StokeDude18/m_monitron/Documentations/captures/40test.JPG

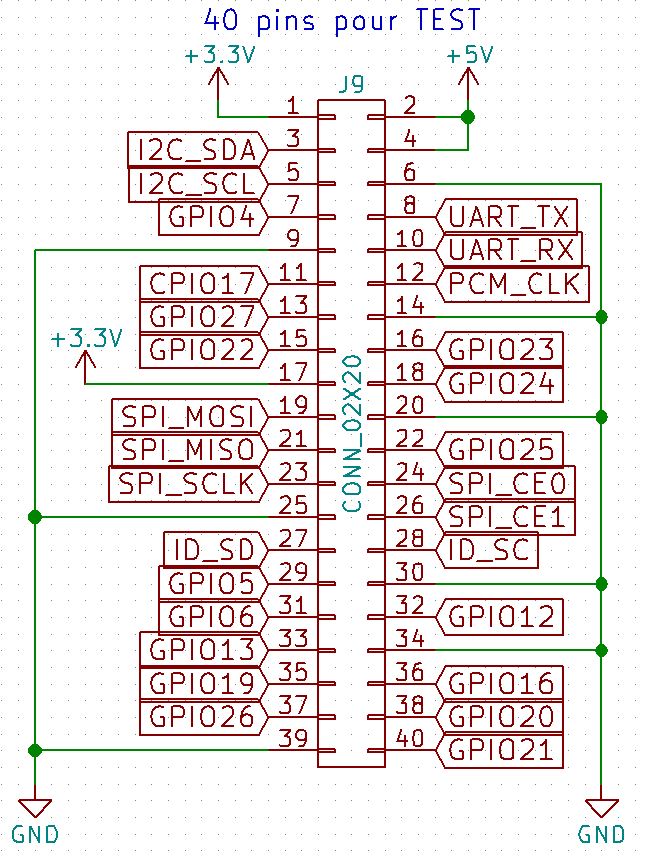
Documentations/captures/40test.JPG
