StokeDude18/m_monitron/Documentations/photos/4.jpg

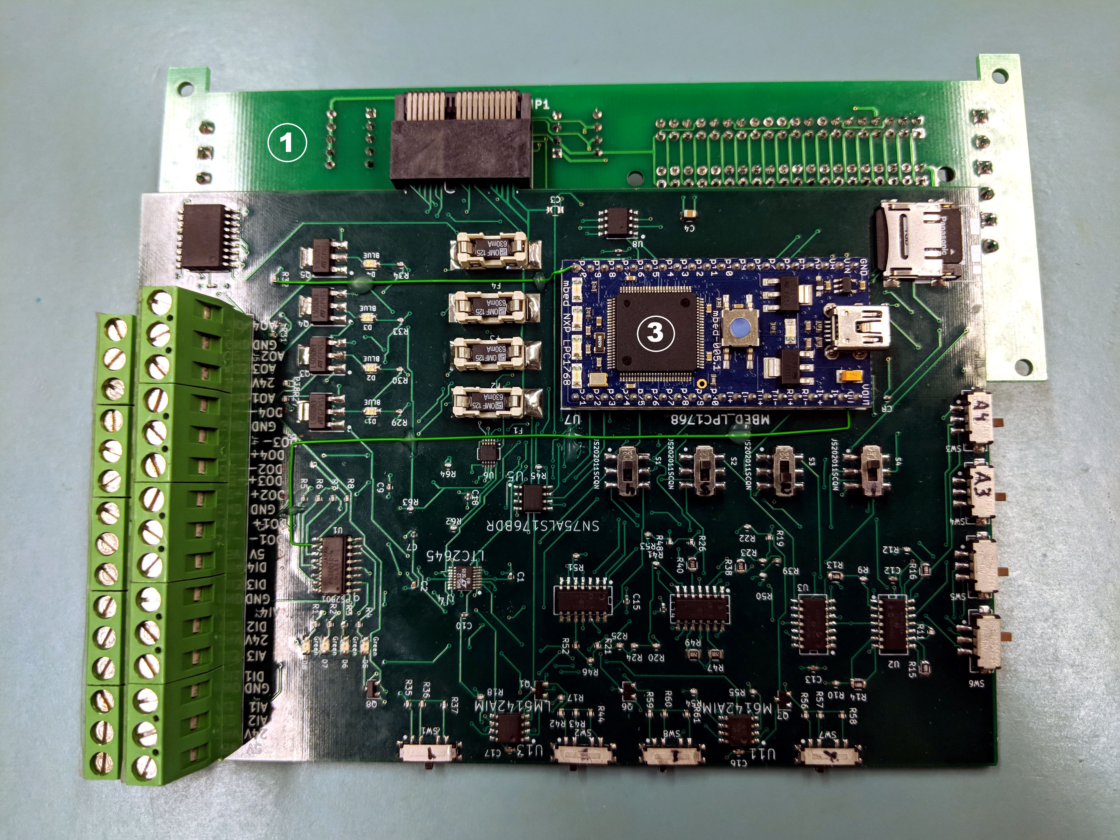
Documentations/photos/4.jpg
