StokeDude18/m_monitron/Documentations/ManuelTechnique_MiniMonitron.docx

Alfred Quintin-Morel

Maina Raiche

Technologie des systèmes ordinés

Groupe : 02317

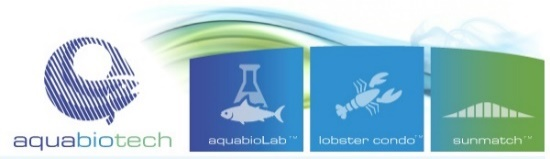
[picture p11: figure]

Mini-Monitron

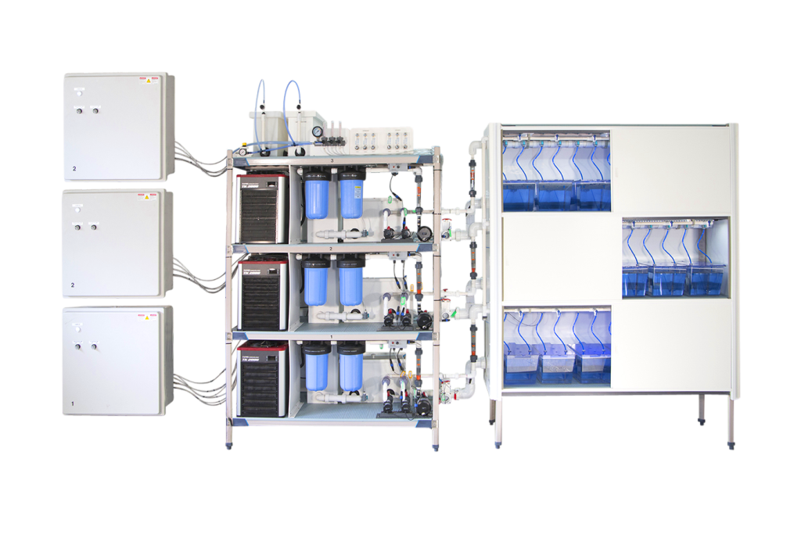
[picture p12: figure]

Manuel technique présenté à

Aquabiotech et Richard Cloutier

Département des technologies du génie électrique

Pour le cours

Projet de fin d’étude

cegep_coul_2225x798

18 mai 2018

# Description du projet

Fonctionnement (Schéma bloc)

Procédure d’installation (pour usager) après fabrication

Générer les fichiers Gerber (.gbr) avec Kicad

Contenu matériel du produit
