StokeDude18/m_monitron/Documentations/SchemaCodeMonitron.pdf

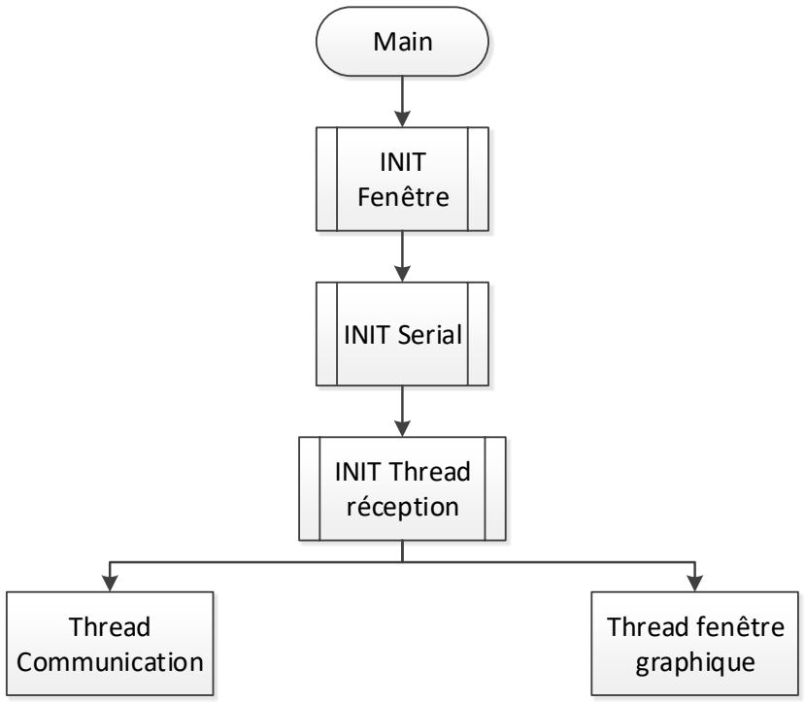
[picture p13: figure]
Main; INIT Fenêtre; INIT Serial; INIT Thread réception; Thread Communication; Thread fenêtre graphique

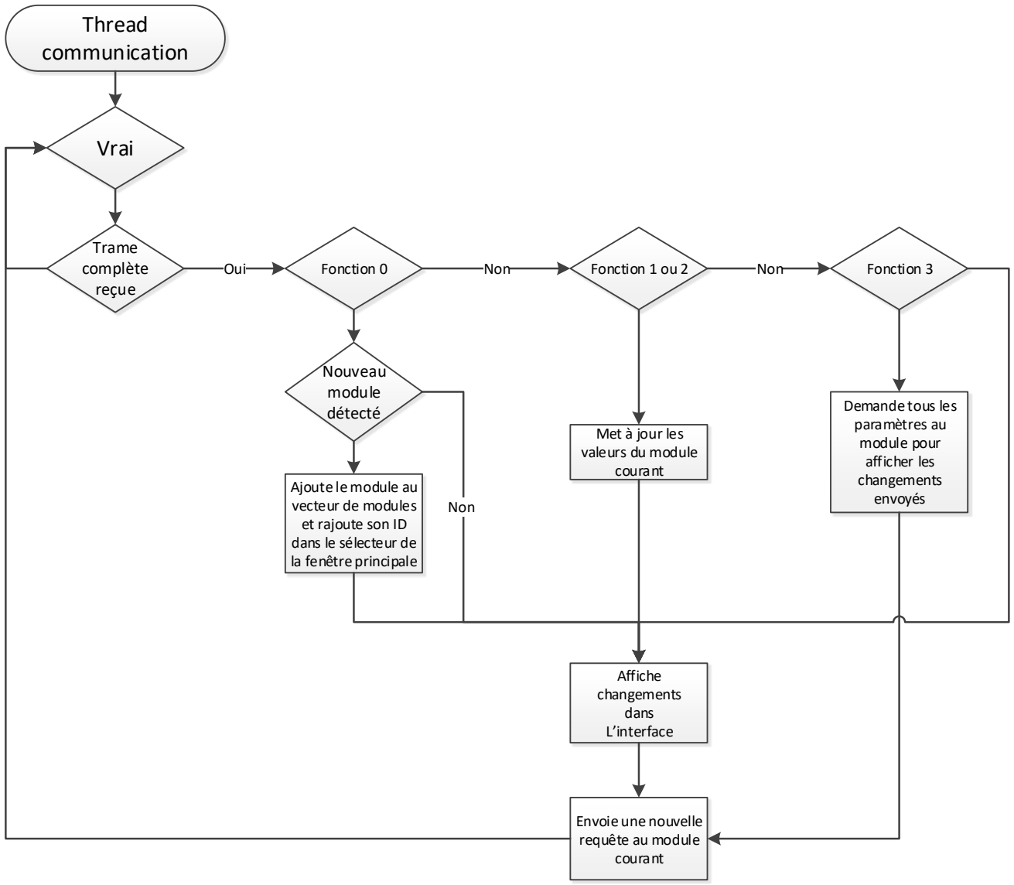
[picture p14: figure]
Thread communication; Vrai; Trame complète reçue; Oui; Fonction 0; Non; Fonction 1 ou 2; Fonction 3; Affiche changements dans L interface; Nouveau module détecté; Ajoute le module au vecteur de modules et rajoute son ID dans le sélecteur de la fenêtre principale; Met à jour les valeurs du module courant; Demande tous les paramètres au module pour afficher les changements envoyés; Envoie une nouvelle requête au module courant
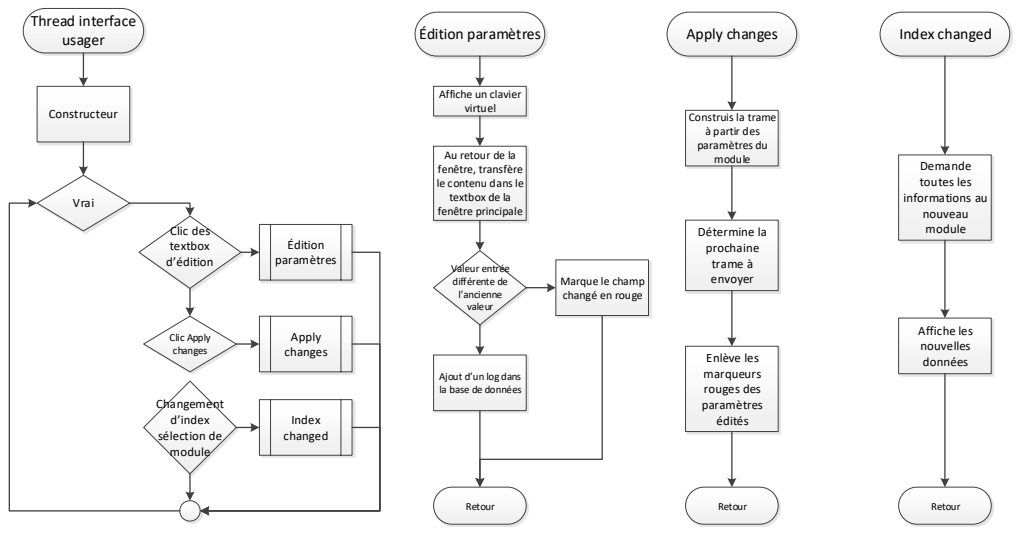
[picture p15: page 3]
Thread interface usager; Constructeur; Vrai; Clic des textbox d édition; Édition paramètres; Clic Apply changes; Apply changes; Changement d index sélection de module; Index changed; Valeur entrée différente de l ancienne valeur; Retour; Détermine la prochaine trame à envoyer; Enlève les marqueurs rouges des paramètres édités; Demande toutes les informations au nouveau module; Affiche les nouvelles données

Affiche un clavier
virtuel

Construis la trame
à partir des
paramètres du
module

Au retour de la
fenêtre, transfère
le contenu dans le
textbox de la
fenêtre principale

Marque le champ
changé en rouge

Ajout d un log dans
la base de données
