StokeDude18/m_monitron/Fiches_Technique/7-344,7-345.pdf

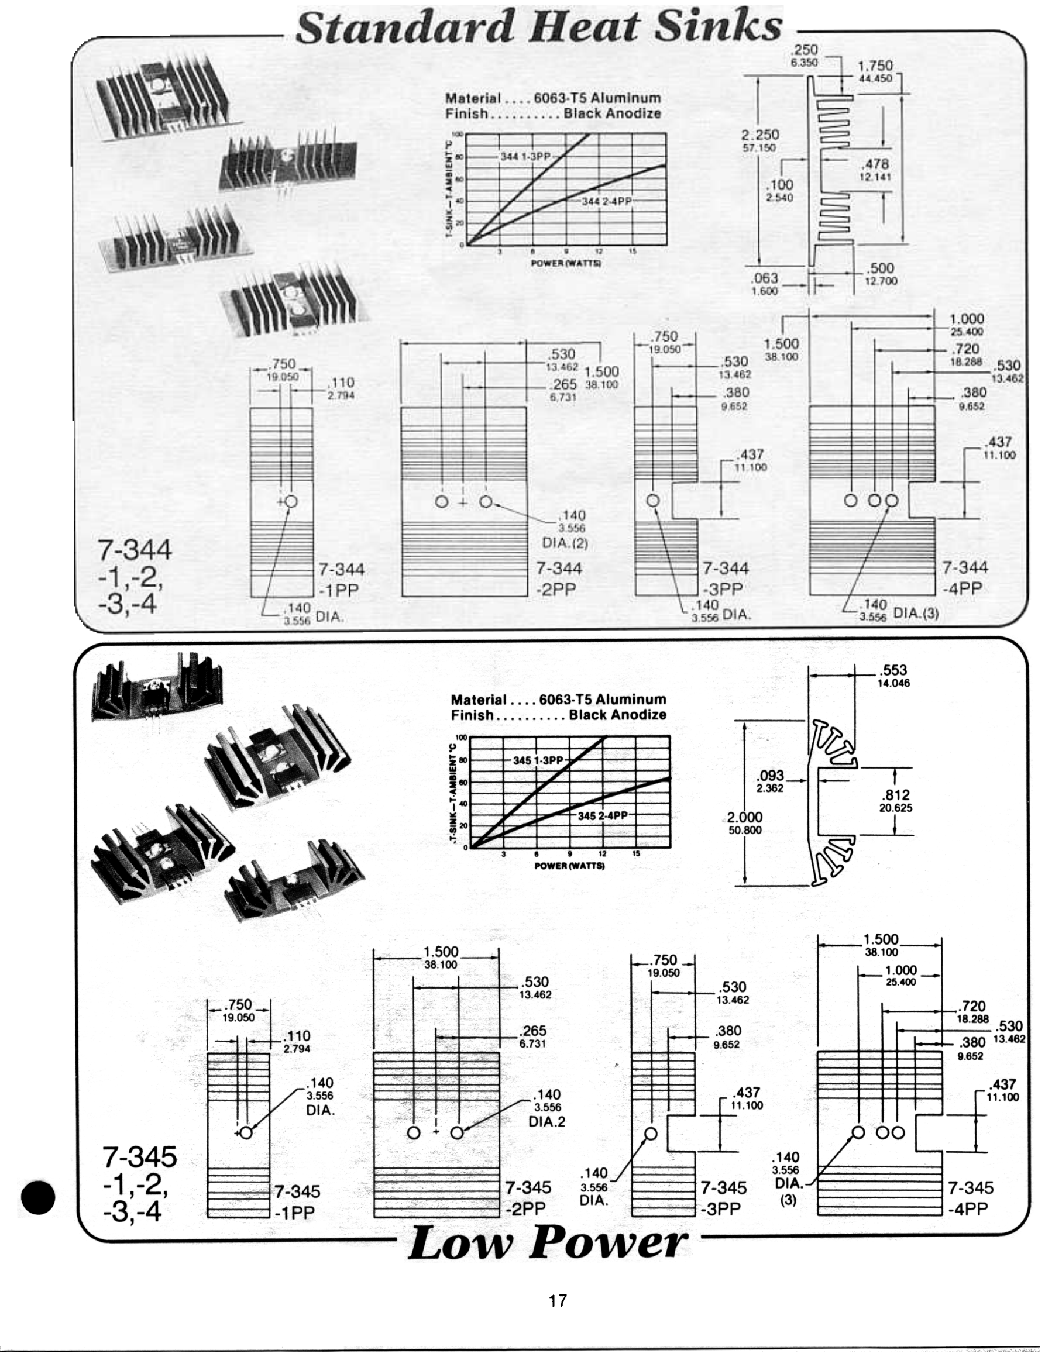
[picture p16: page 1]

17
