StokeDude18/m_monitron/Documentations/captures/24VDC.JPG

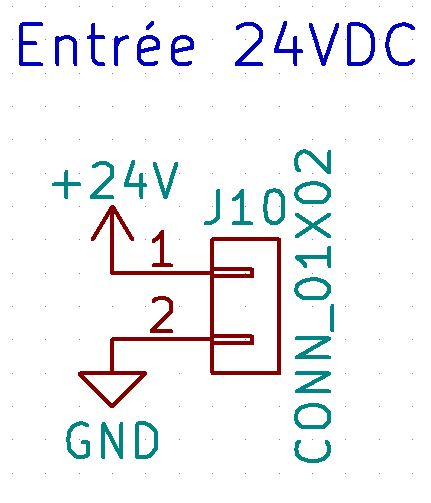
Documentations/captures/24VDC.JPG
