StokeDude18/m_monitron/Documentations/captures/40PI.JPG

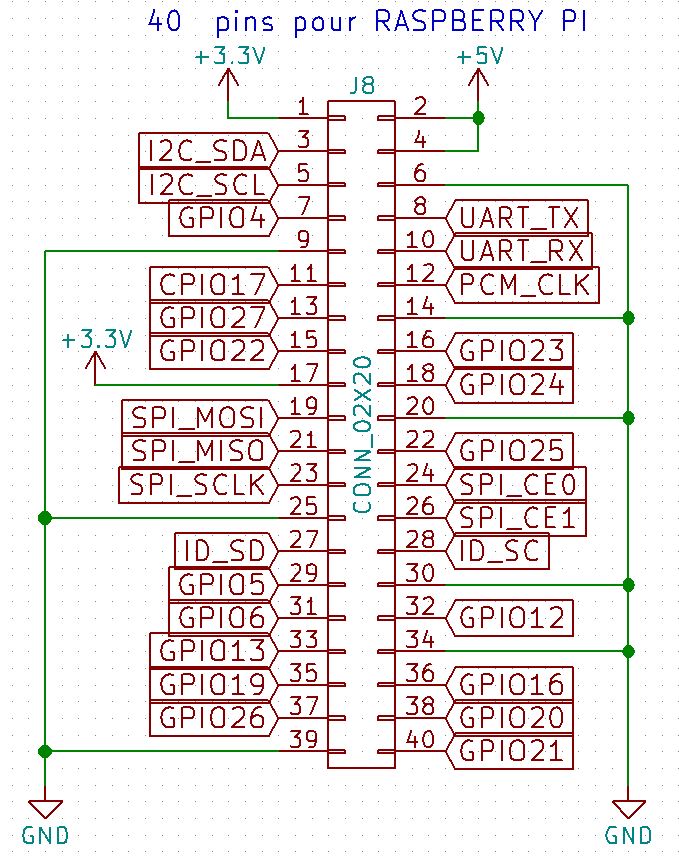
Documentations/captures/40PI.JPG
