StokeDude18/m_monitron/Documentations/captures/alim_mod.JPG

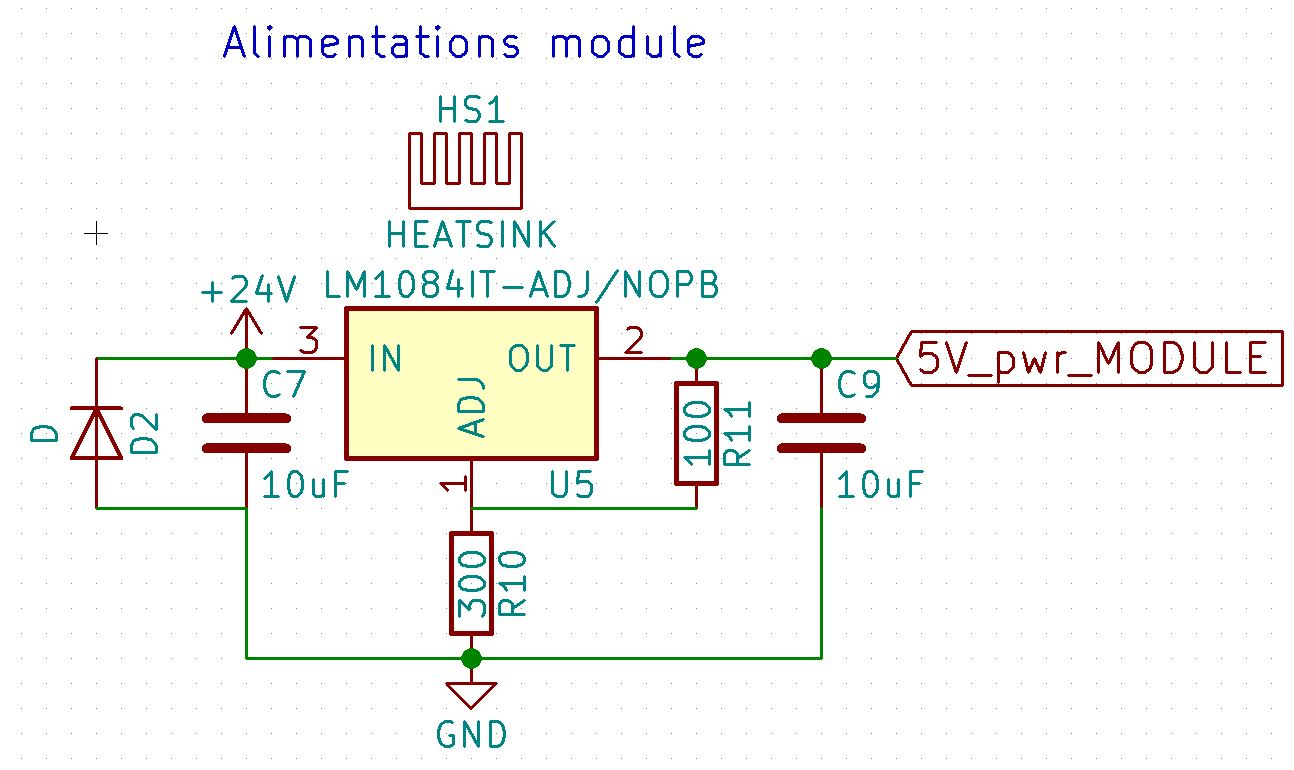
Documentations/captures/alim_mod.JPG
