StokeDude18/m_monitron/Documentations/captures/alim_PI.JPG

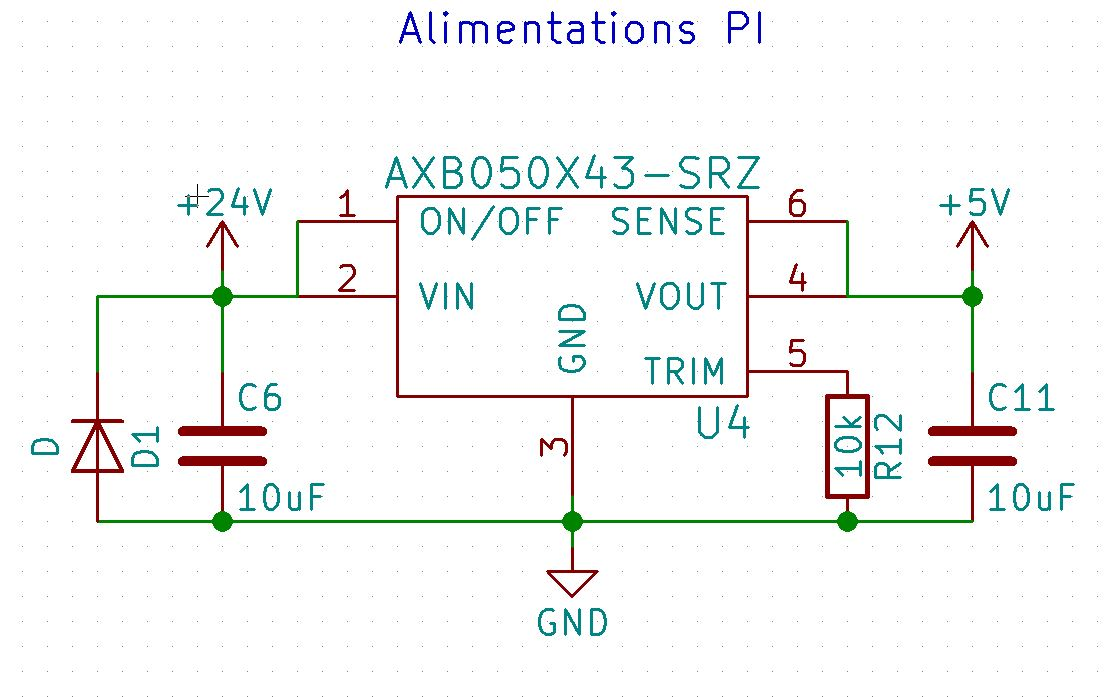
Documentations/captures/alim_PI.JPG
