StokeDude18/m_monitron/Documentations/captures/borniers.JPG

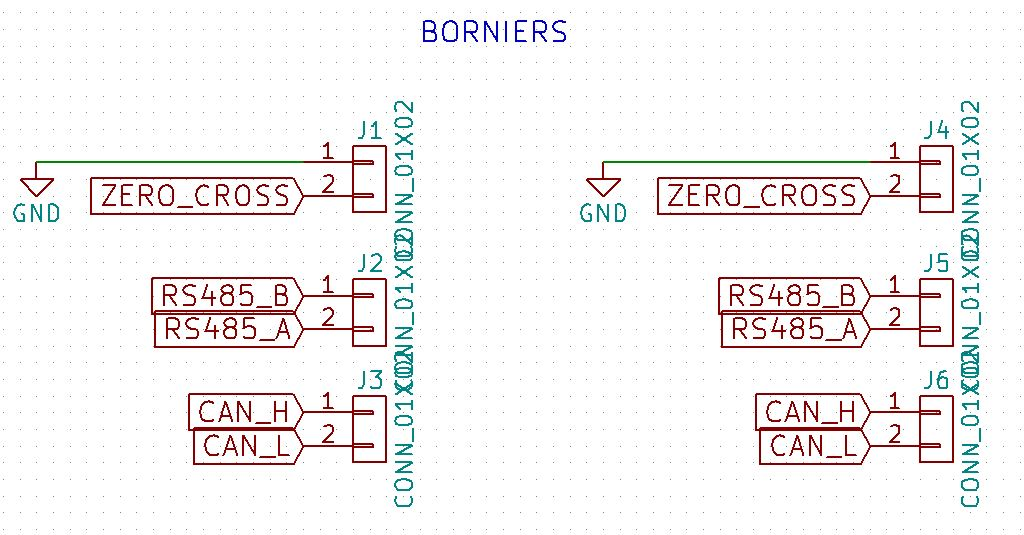
Documentations/captures/borniers.JPG
