StokeDude18/m_monitron/Documentations/captures/c_PI.JPG

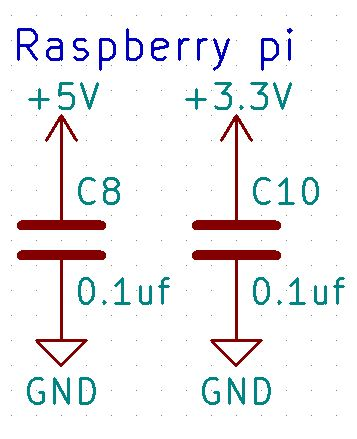
Documentations/captures/c_PI.JPG
