StokeDude18/m_monitron/Documentations/captures/CAN.JPG

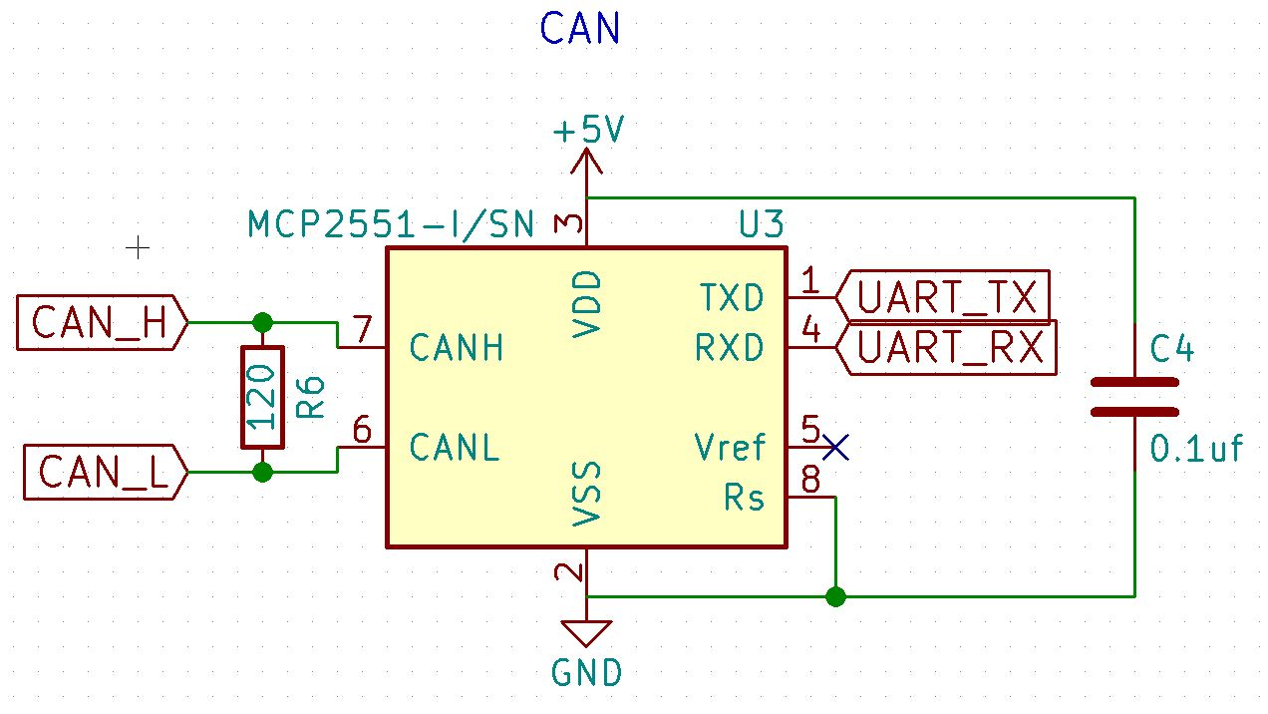
Documentations/captures/CAN.JPG
