StokeDude18/m_monitron/Documentations/captures/mysql1.JPG

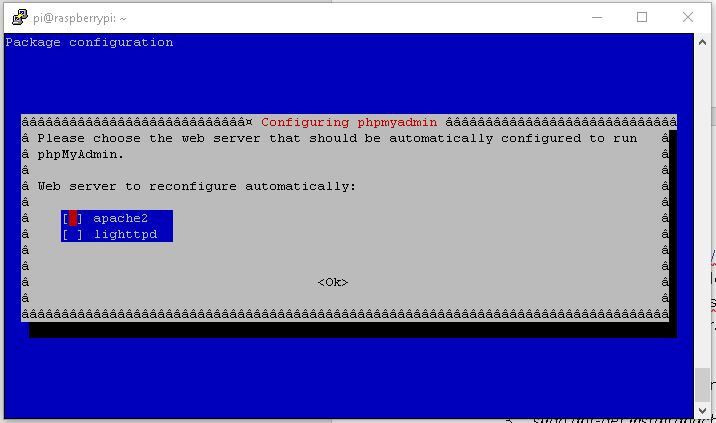
Documentations/captures/mysql1.JPG
