StokeDude18/m_monitron/Documentations/captures/mysql2.JPG

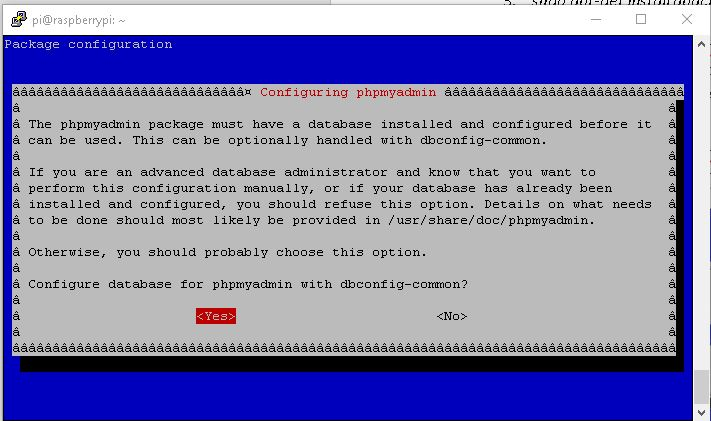
Documentations/captures/mysql2.JPG
