StokeDude18/m_monitron/Documentations/captures/mysql3.JPG

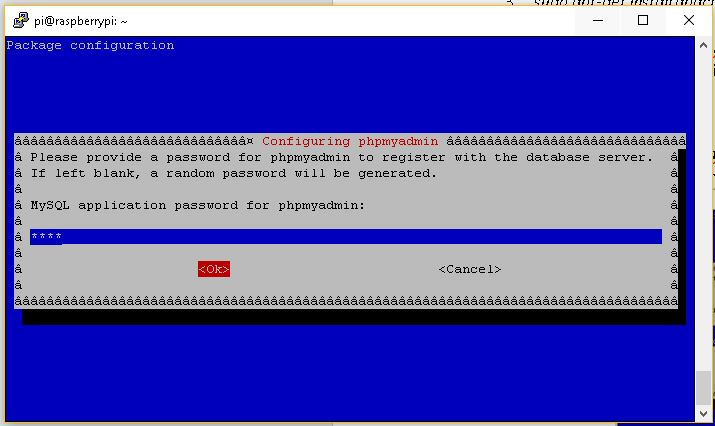
Documentations/captures/mysql3.JPG
