StokeDude18/m_monitron/Documentations/captures/mysql4.JPG

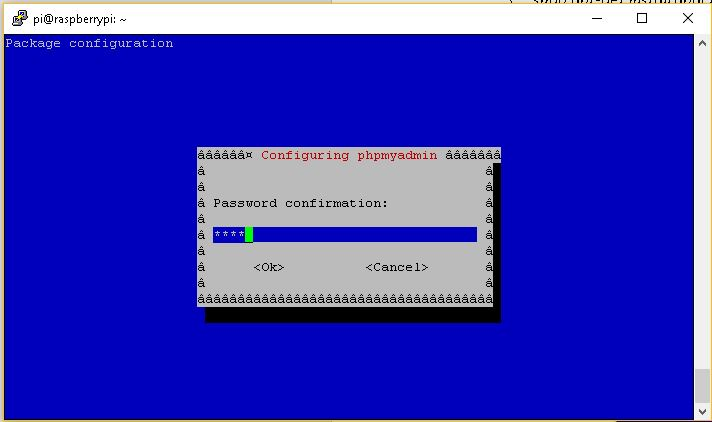
Documentations/captures/mysql4.JPG
