StokeDude18/m_monitron/Documentations/captures/mysql5.JPG

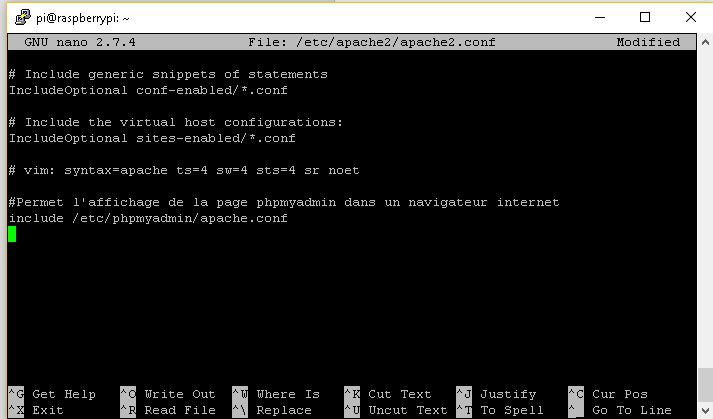
Documentations/captures/mysql5.JPG
