StokeDude18/m_monitron/Documentations/captures/ordino0.JPG

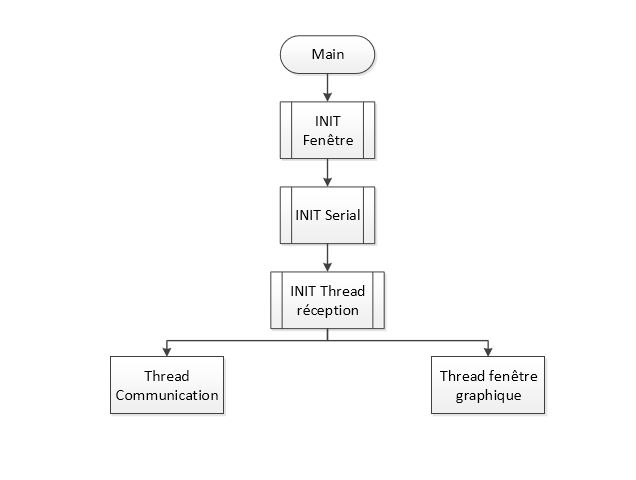
Documentations/captures/ordino0.JPG
