StokeDude18/m_monitron/Documentations/captures/ordino1.JPG

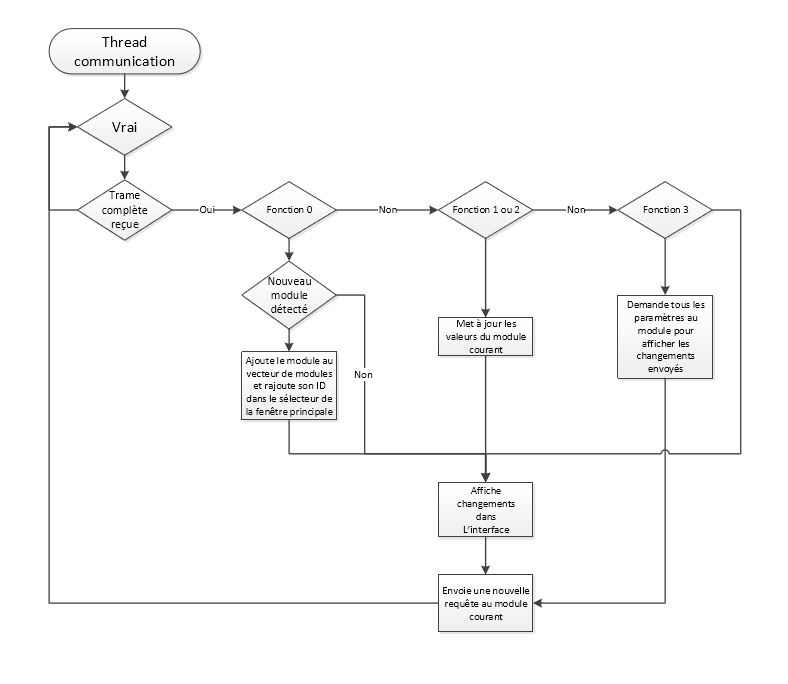
Documentations/captures/ordino1.JPG
