StokeDude18/m_monitron/Documentations/captures/pcie.JPG

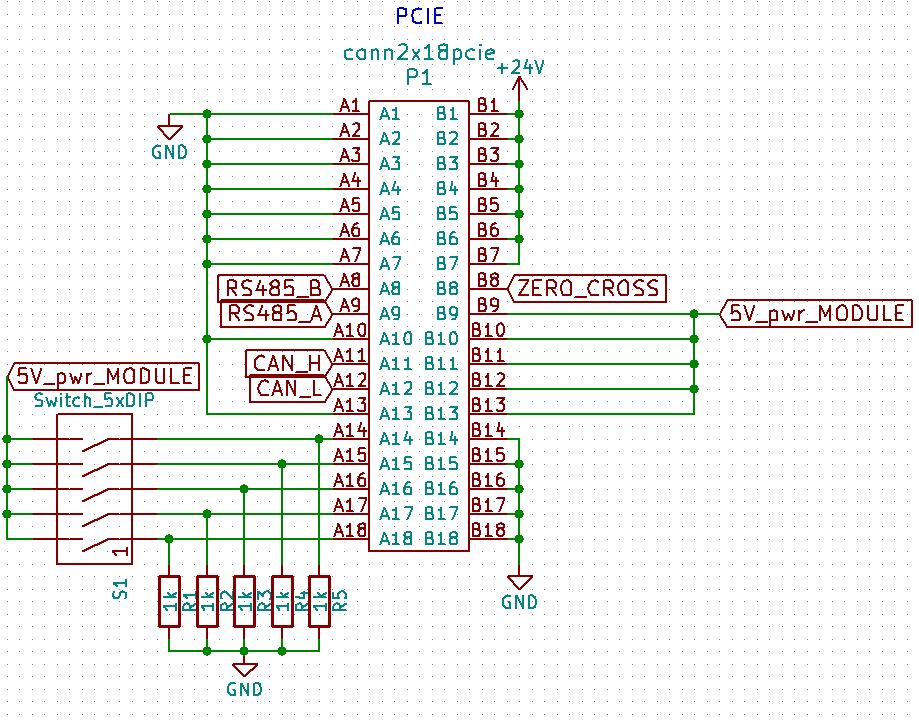
Documentations/captures/pcie.JPG
