StokeDude18/m_monitron/Documentations/captures/rtc.JPG

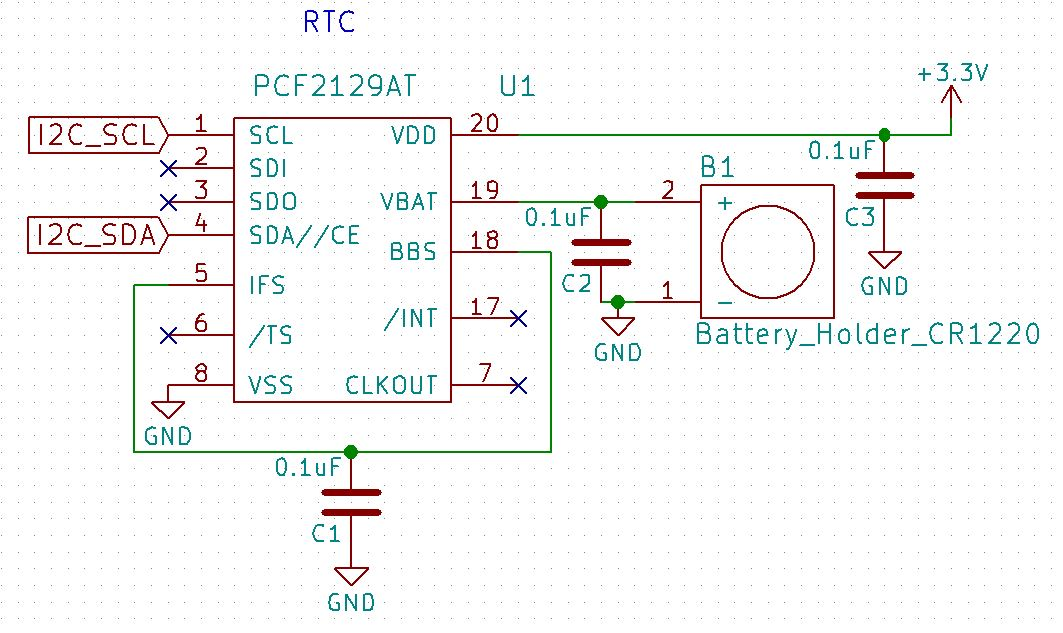
Documentations/captures/rtc.JPG
