StokeDude18/m_monitron/Documentations/captures/schemaelec.JPG

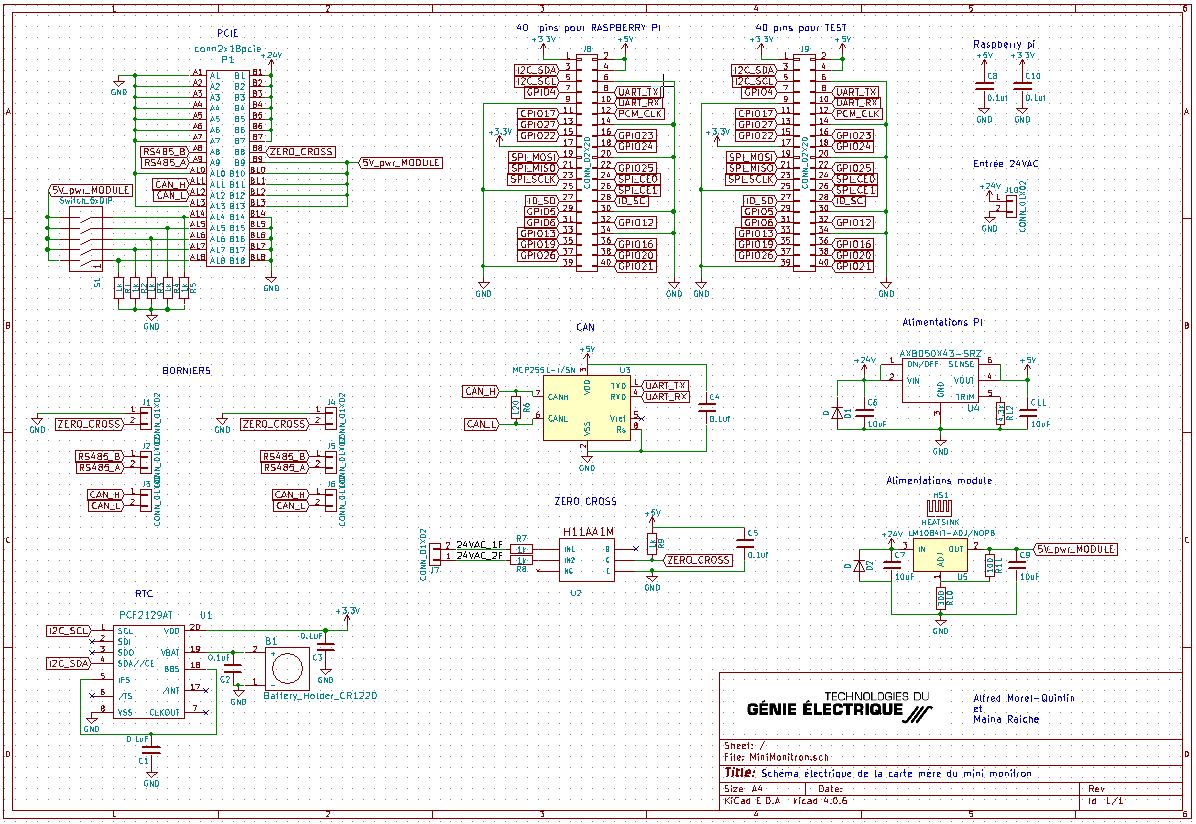
Documentations/captures/schemaelec.JPG
