StokeDude18/m_monitron/Documentations/captures/zerocross.JPG

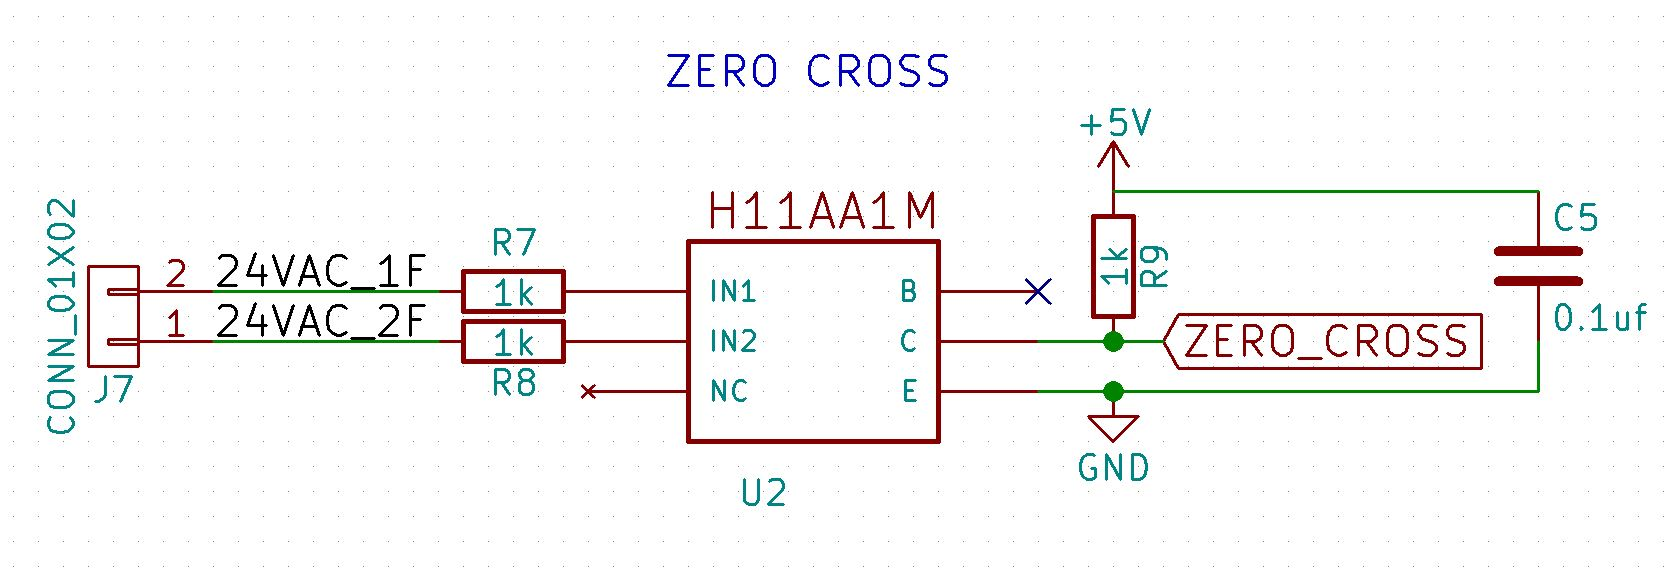
Documentations/captures/zerocross.JPG
