StokeDude18/m_monitron/Documentations/photos/0.jpg

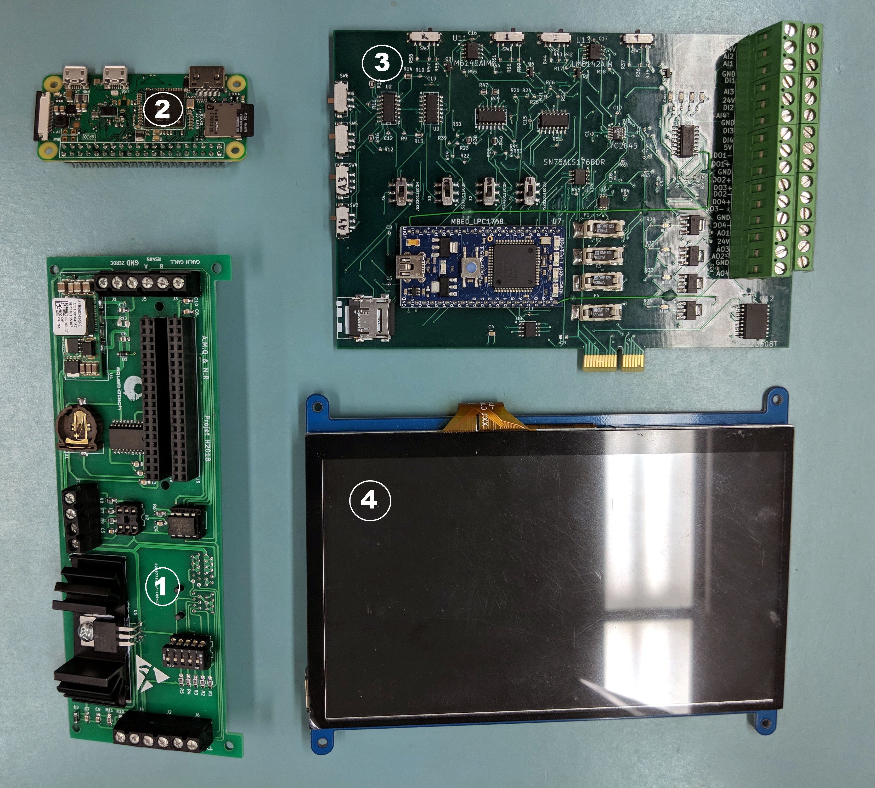
Documentations/photos/0.jpg
