StokeDude18/m_monitron/Documentations/photos/1.jpg

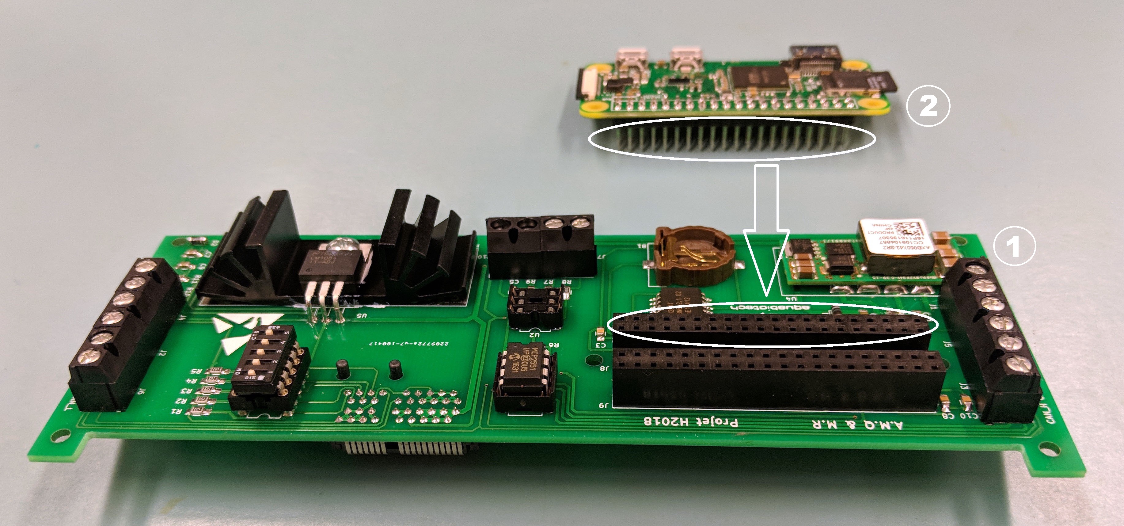
Documentations/photos/1.jpg
