StokeDude18/m_monitron/Documentations/photos/2.jpg

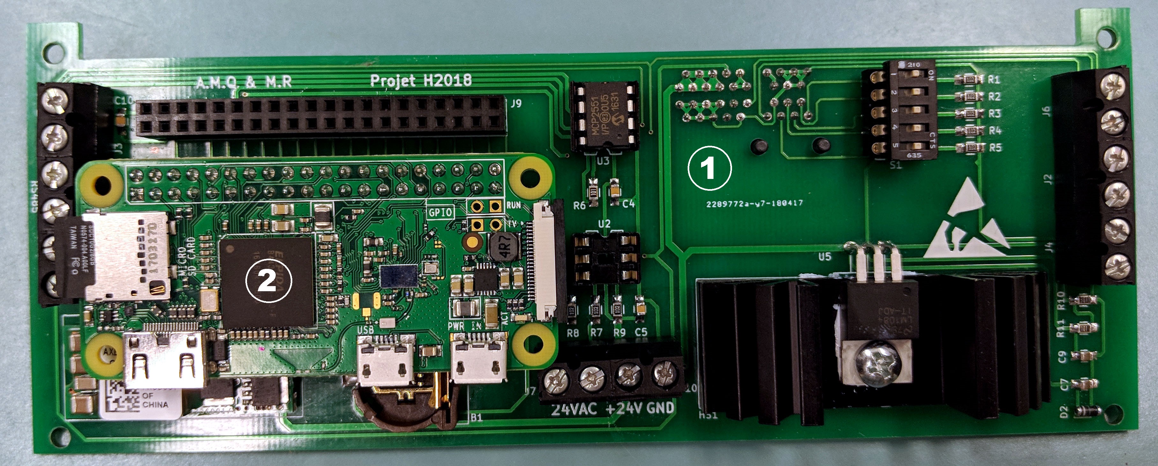
Documentations/photos/2.jpg
