StokeDude18/m_monitron/Documentations/photos/3.jpg

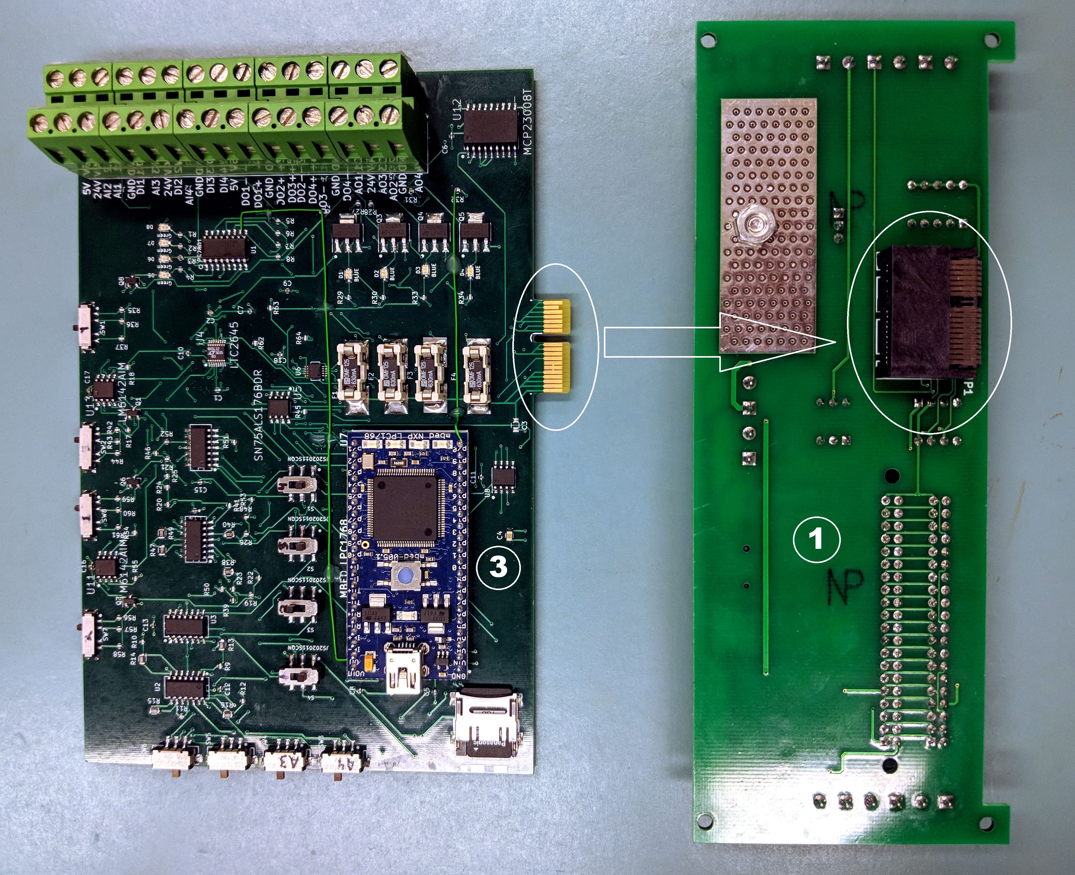
Documentations/photos/3.jpg
