StokeDude18/m_monitron/Documentations/photos/5.jpg

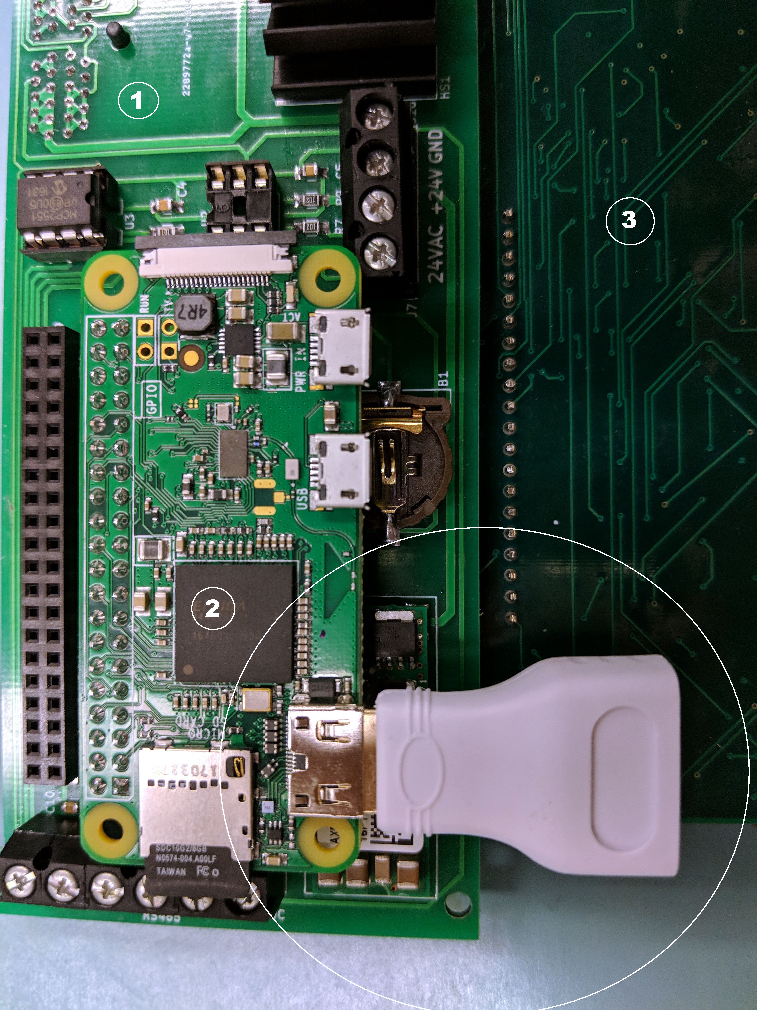
Documentations/photos/5.jpg
