StokeDude18/m_monitron/Documentations/photos/6.jpg

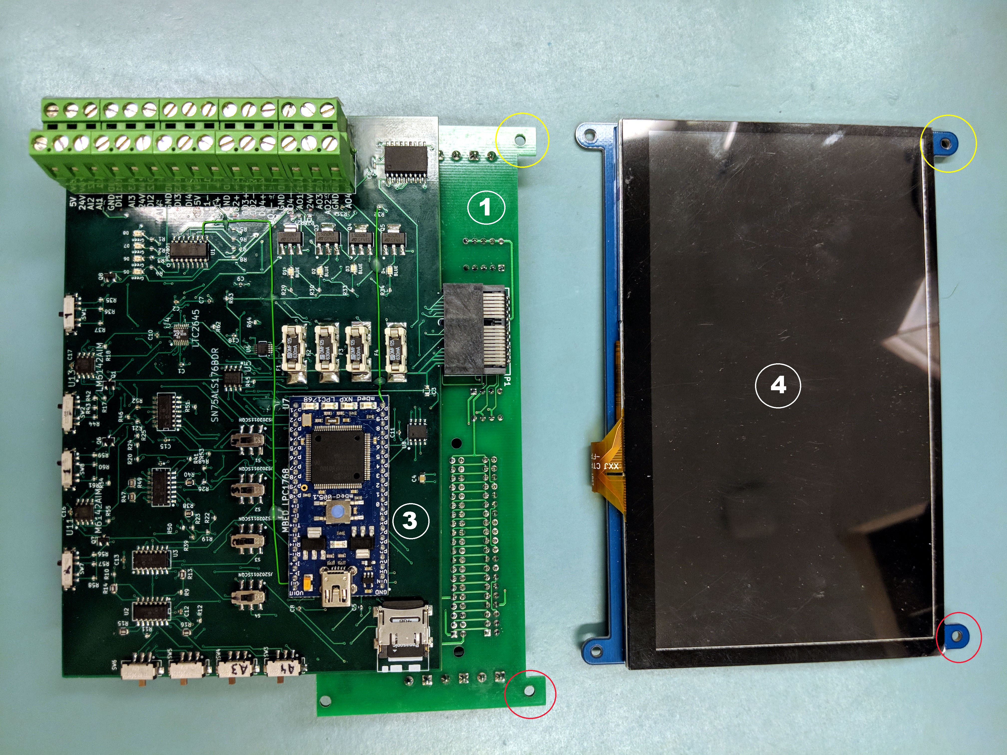
Documentations/photos/6.jpg
