StokeDude18/m_monitron/Documentations/photos/7.jpg

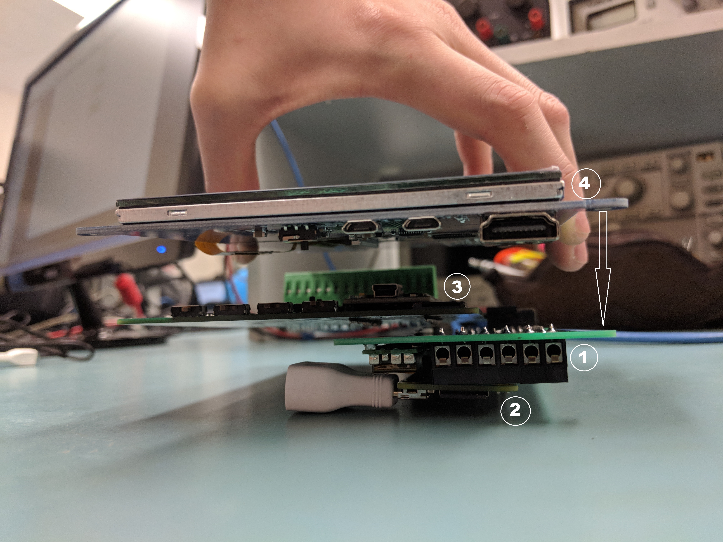
Documentations/photos/7.jpg
