StokeDude18/m_monitron/Documentations/photos/32673401_1691109287644016_2997711182028079104_n.jpg

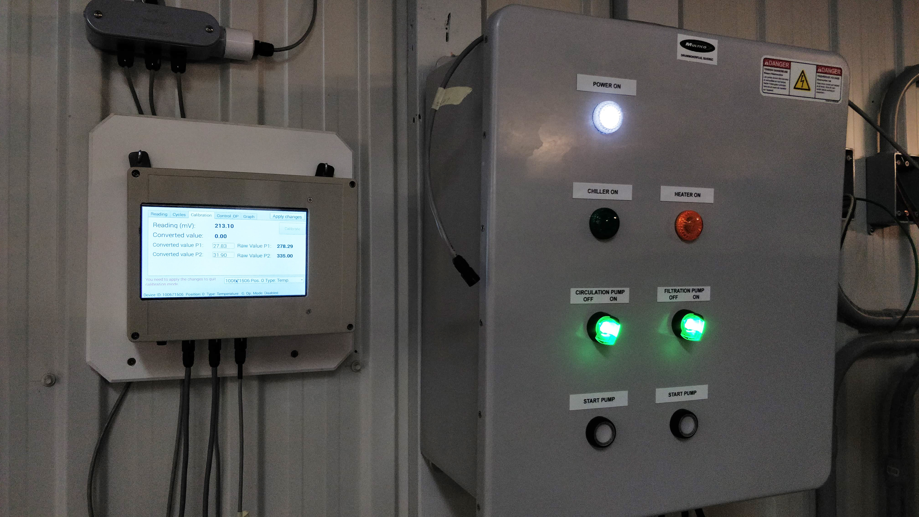
Documentations/photos/32673401_1691109287644016_2997711182028079104_n.jpg
