StokeDude18/m_monitron/Documentations/schema.pdf

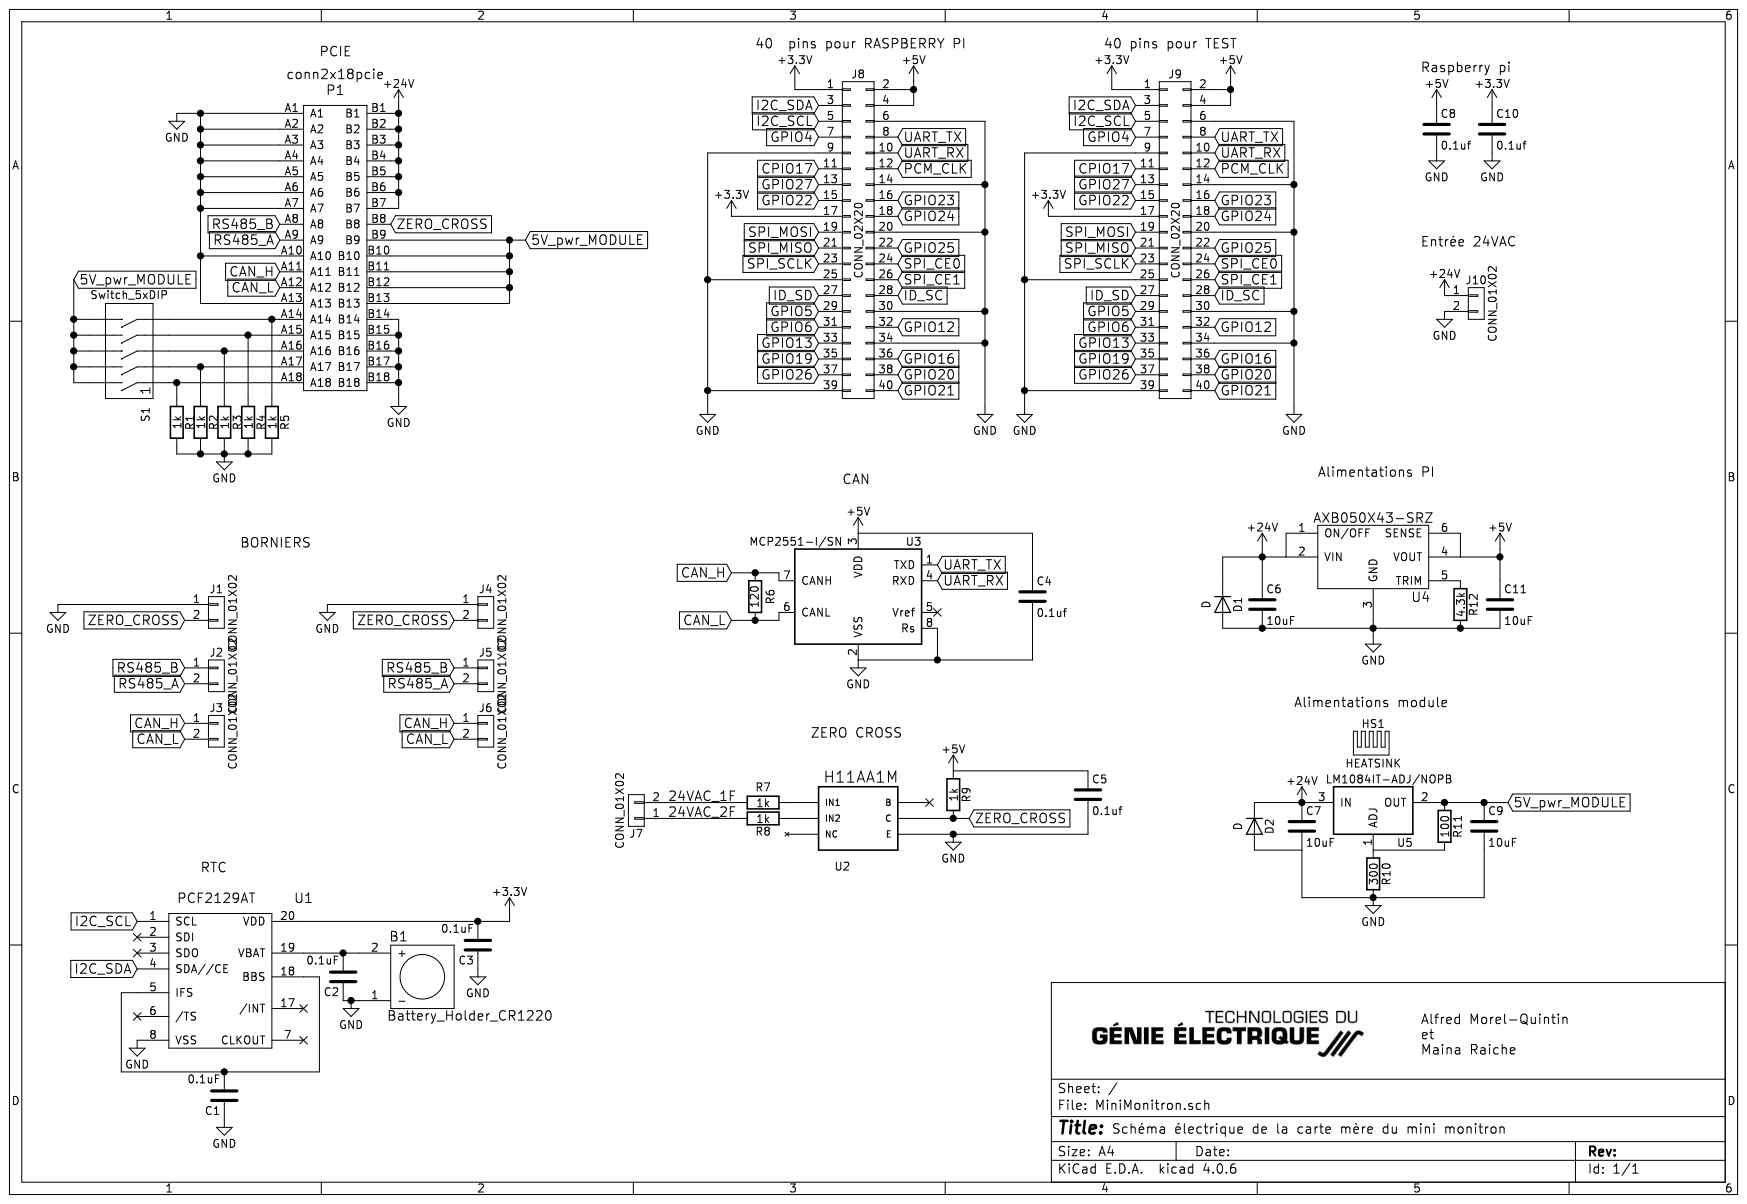
[picture p43: page 1]
