StokeDude18/m_monitron/Fiches_Technique/ASS_0595_HS.pdf

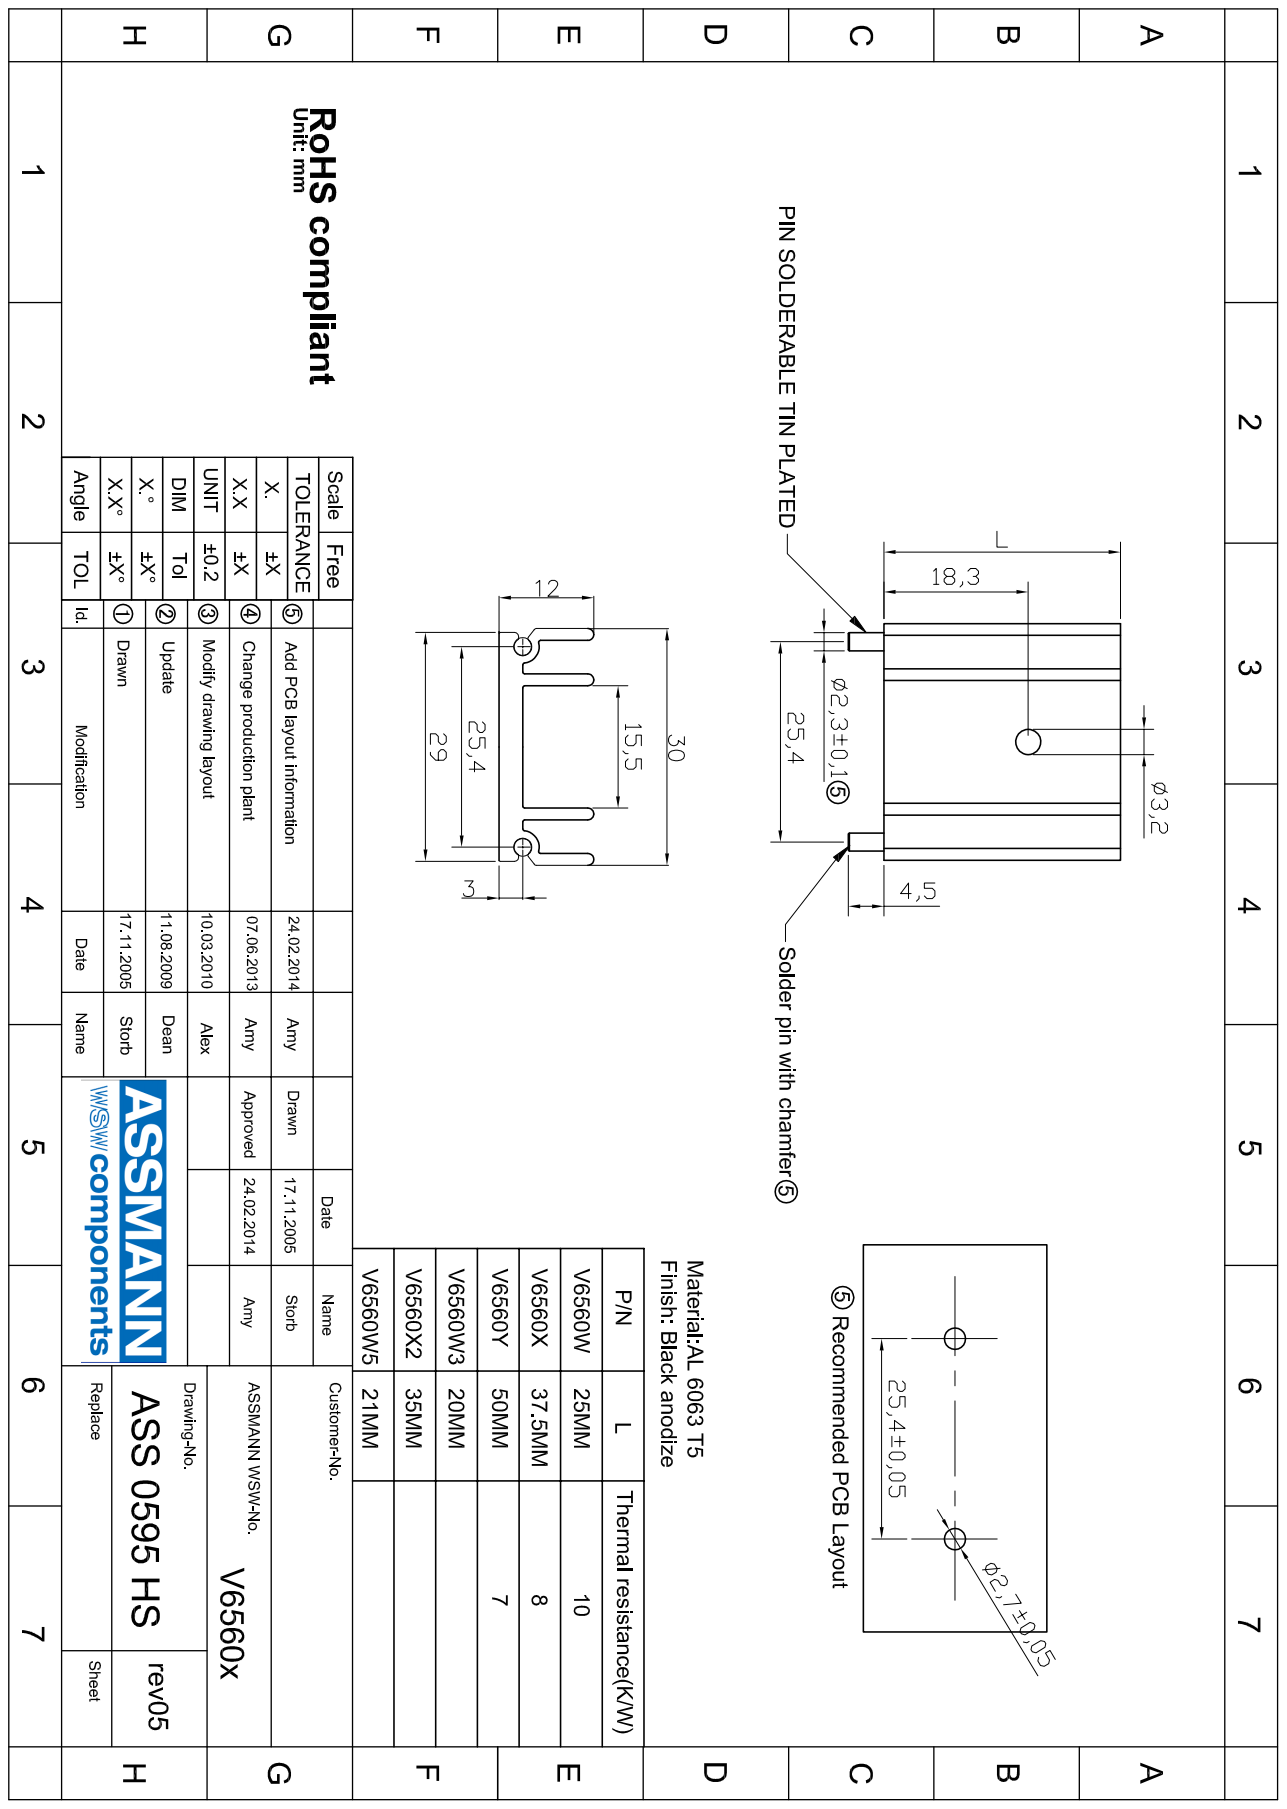
[picture p44: page 1]
