StokeDude18/m_monitron/Fiches_Technique/BK-917_Dwg.pdf

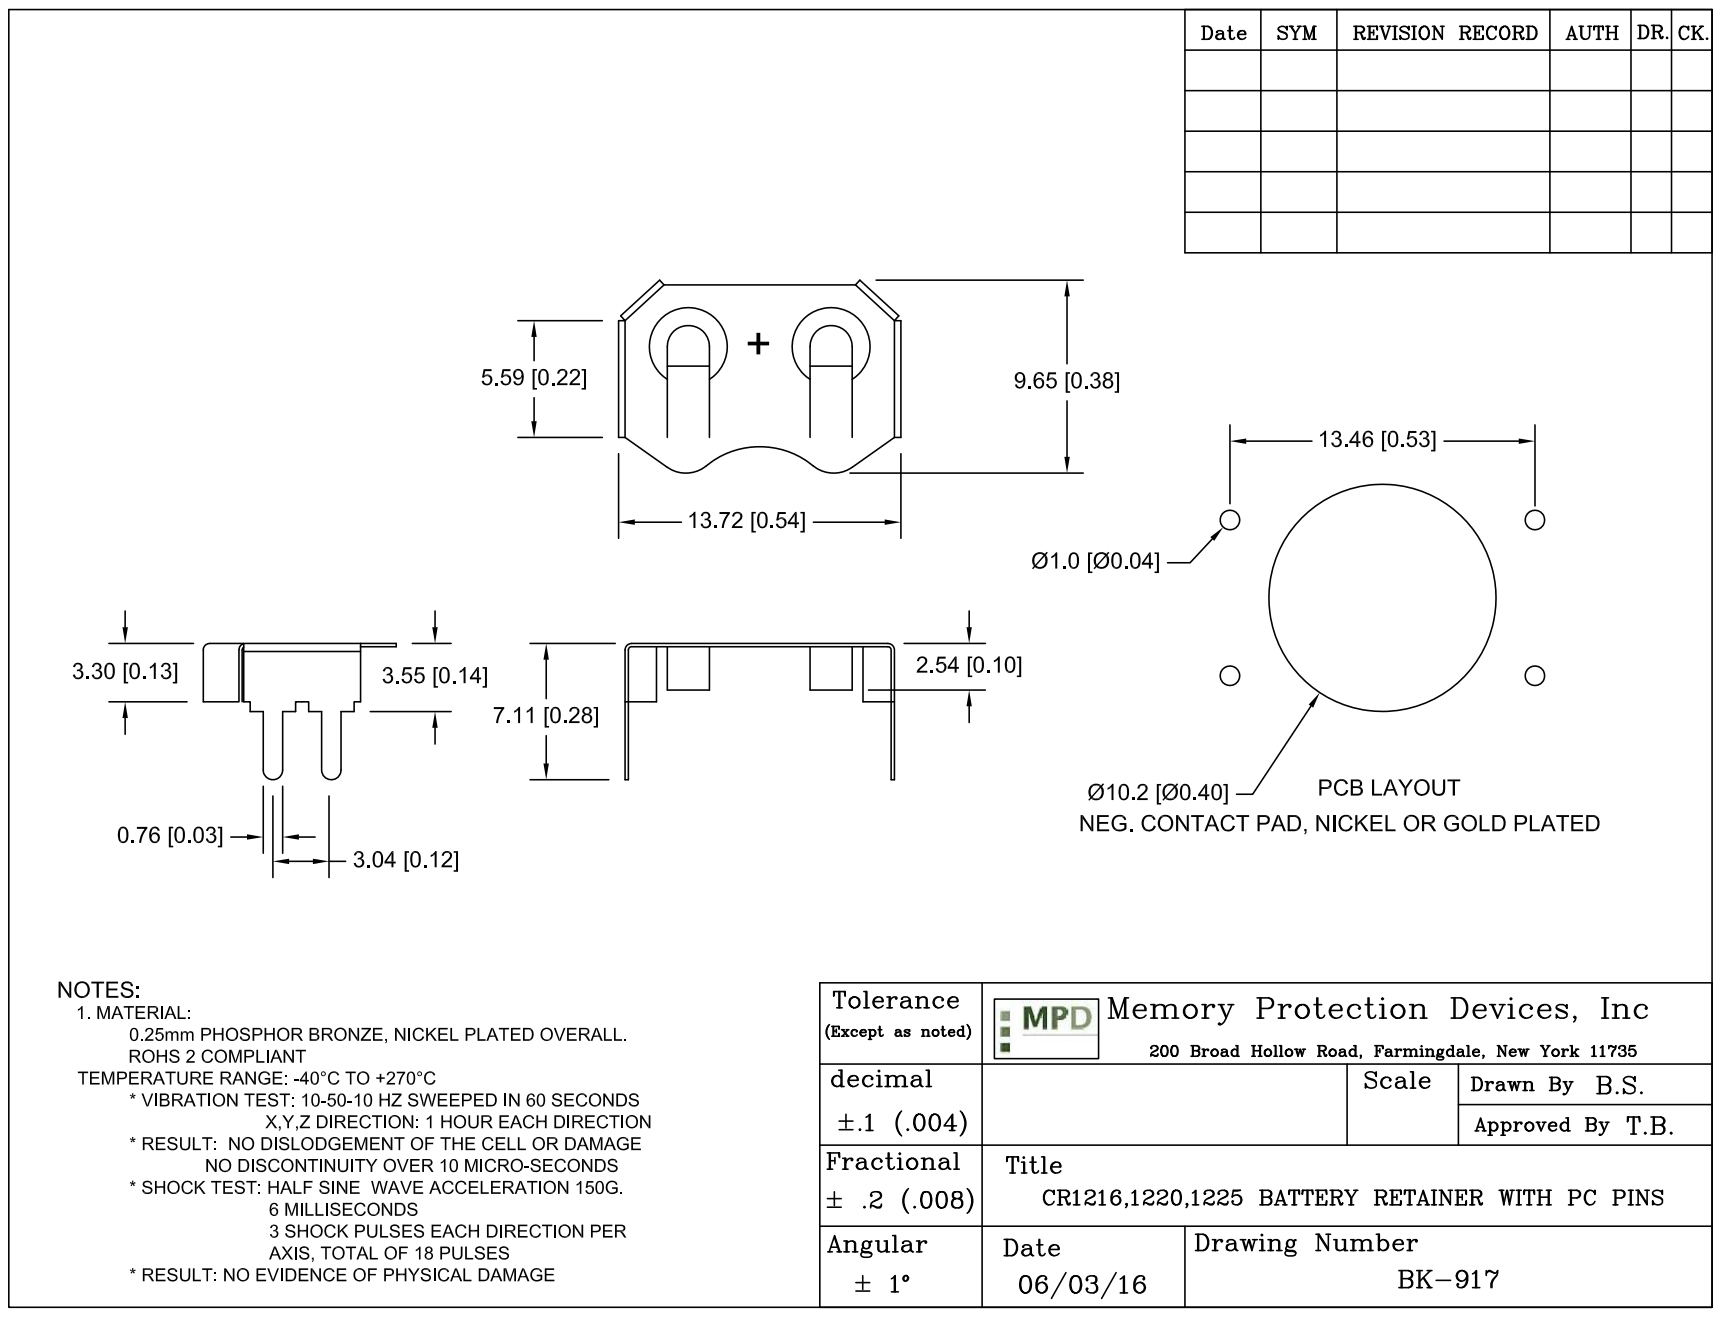
[picture p45: page 1]
