StokeDude18/m_monitron/Schema/MiniMonitron.kicad_pcb

## KiCad design Schema/MiniMonitron.kicad_pcb (2018-05-15)

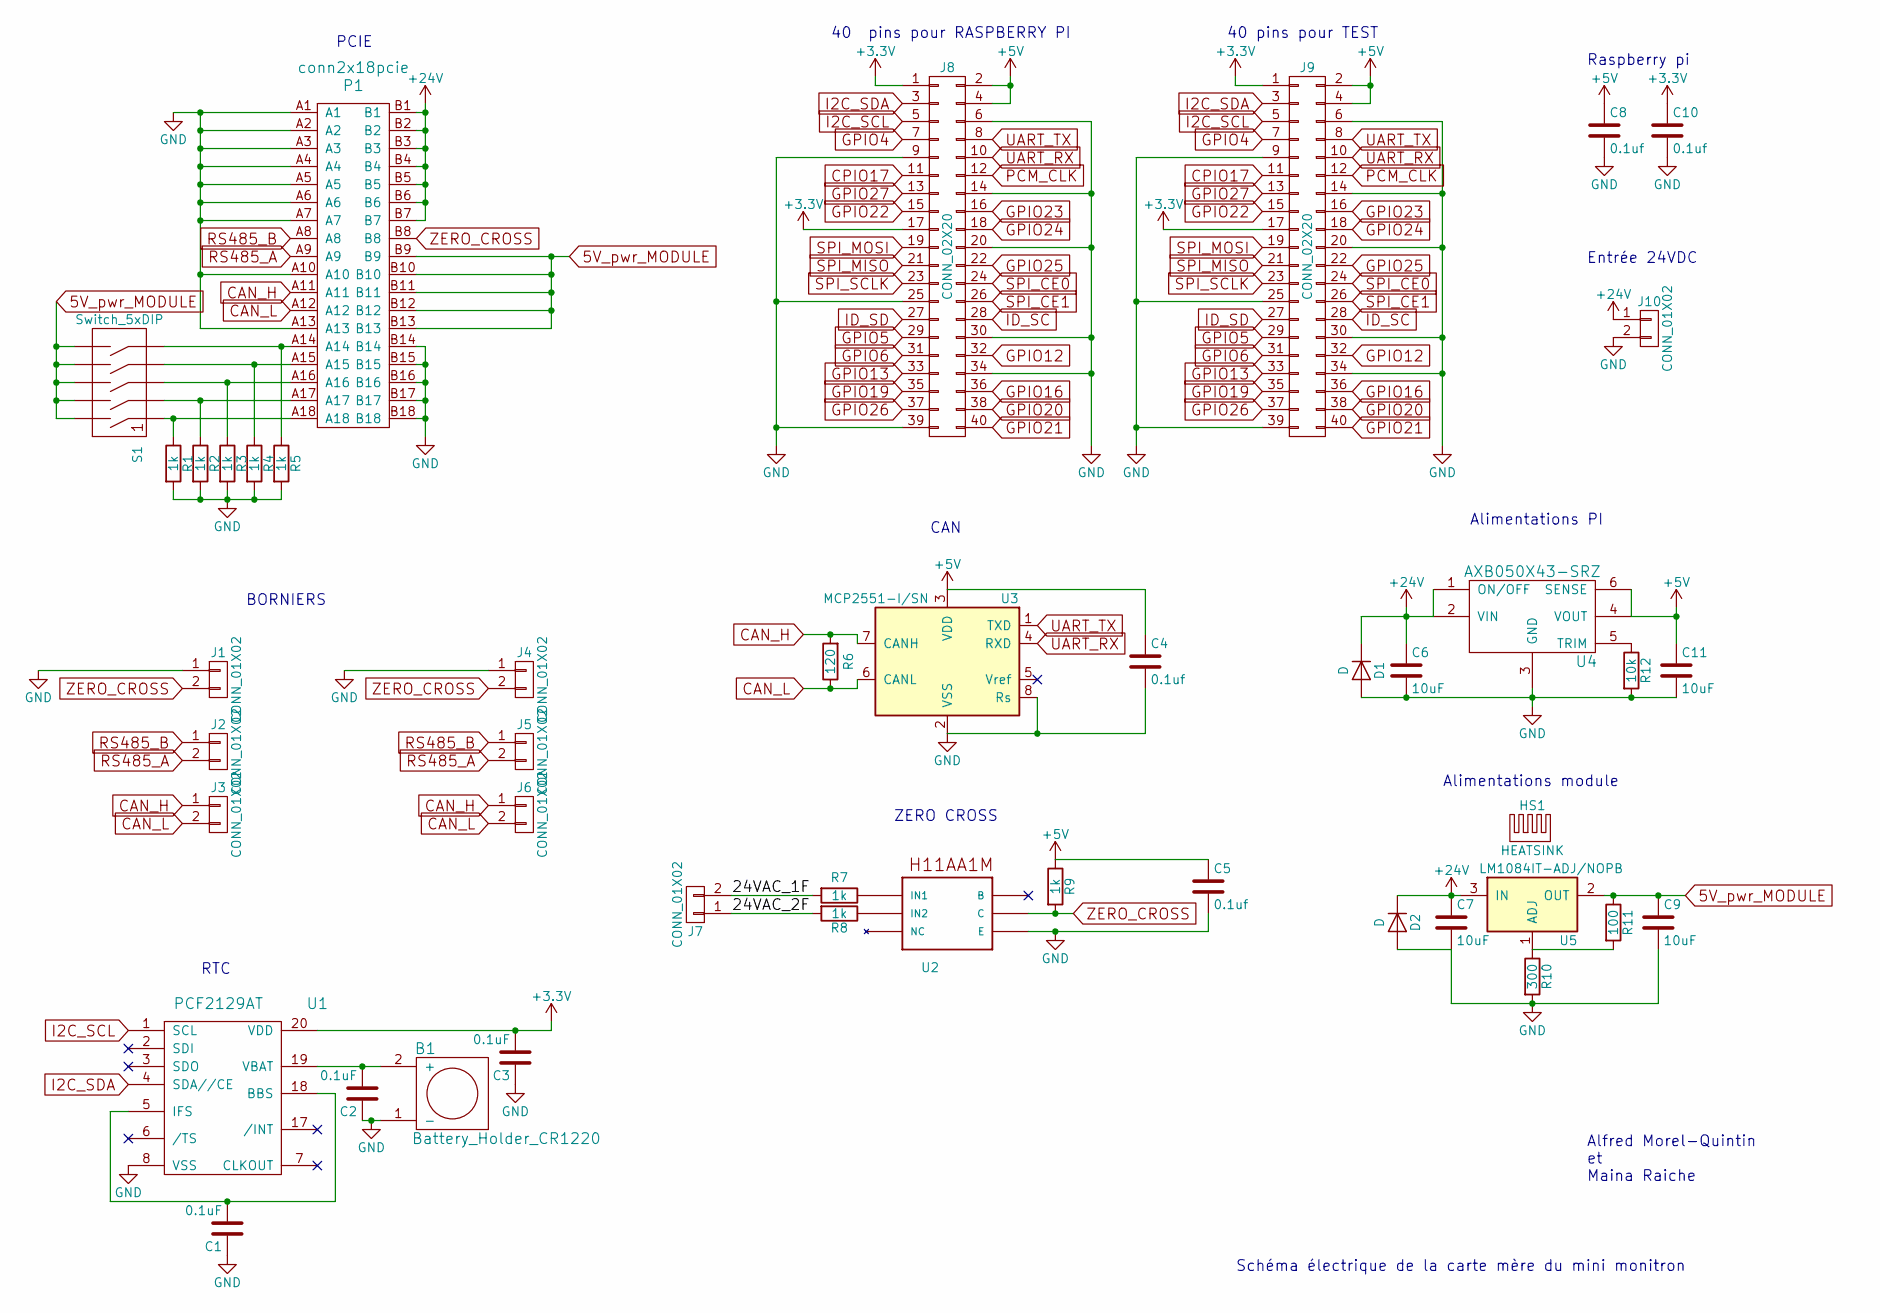
[picture p46: schematic MiniMonitron.sch]

Parts:
B1: Battery_Holder_CR1220; Keystone_CR1220_SMD
C1, C2, C3: 0.1uF; C_0805_HandSoldering
C4, C5, C8, C10: 0.1uf; C_0805_HandSoldering
C6, C7, C9, C11: 10uF; C_0805_HandSoldering
D1, D2: D; D_0805
HS1: HEATSINK; HeatSink_TO220_Vertical_1PP
J1, J2, J3, J4, J5, J6, J7, J10: CONN_01X02; bornier2
J8, J9: CONN_02X20; Pin_Header_Straight_2x20_Pitch2.54mm
P1: conn2x18pcie; pci-x_conn-x1_Vertical_back
R1, R2, R3, R4, R5, R7, R8, R9: 1k; R_0805_HandSoldering
R6: 120; R_0805_HandSoldering
R10: 300; R_0805_HandSoldering
R11: 100; R_0805_HandSoldering
R12: 10k; R_0805_HandSoldering
S1: Switch_5xDIP; DIP-10_W7.62mm
U1: PCF2129AT; SOIC-20W_7.5x12.8mm_Pitch1.27mm
U2: H11AA1M; DIP-6_W7.62mm
U3: MCP2551-I/SN; DIP-8_W7.62mm
U4: AXB050X43-SRZ
U5: LM1084IT-ADJ/NOPB; TO-220_Horizontal

Connections:
5V_pwr_MODULE: C9.1, P1.B9, P1.B10, P1.B11, P1.B12, P1.B13, R11.1, S1.6, S1.7, S1.8, S1.9, S1.10, U5.2 (OUT)
+3V3: C3.2, C10.1, J8.1, J8.17, J9.1, J9.17, U1.20 (VDD)
+5V: C4.1, C5.1, C8.1, C11.1, J8.2, J8.4, J9.2, J9.4, R9.1, U3.3 (VDD), U4.4 (VOUT), U4.6 (SENSE)
+24V: C6.1, C7.1, D1.1 (K), D2.1 (K), J10.1, P1.B1, P1.B2, P1.B3, P1.B4, P1.B5, P1.B6, P1.B7, U4.1 (ON/OFF), U4.2 (VIN), U5.3 (IN)
/24VAC_1F: J7.2, R7.2
/24VAC_2F: J7.1, R8.2
CAN_H: J3.1, J6.1, P1.A11, R6.2, U3.7 (CANH)
CAN_L: J3.2, J6.2, P1.A12, R6.1, U3.6 (CANL)
CPIO17: J8.11, J9.11
GND: B1.1 (-), C1.1, C2.1, C3.1, C4.2, C5.2, C6.2, C7.2, C8.2, C9.2, C10.2, C11.2, D1.2 (A), D2.2 (A), J1.1, J4.1, J8.6, J8.9, J8.14, J8.20, J8.25, J8.30, J8.34, J8.39, J9.6, J9.9, J9.14, J9.20, J9.25, J9.30, J9.34, J9.39, J10.2, P1.A1, P1.A2, P1.A3, P1.A4, P1.A5, P1.A6, P1.A7, P1.A10, P1.A13, P1.B14, P1.B15, P1.B16, P1.B17, P1.B18, R1.2, R2.2, R3.2, R4.2, R5.2, R10.2, R12.2, U1.8 (VSS), U2.4 (E), U3.2 (VSS), U3.8 (Rs), U4.3 (GND)
GPIO4: J8.7, J9.7
GPIO5: J8.29, J9.29
GPIO6: J8.31, J9.31
GPIO12: J8.32, J9.32
GPIO13: J8.33, J9.33
GPIO16: J8.36, J9.36
GPIO19: J8.35, J9.35
GPIO20: J8.38, J9.38
GPIO21: J8.40, J9.40
GPIO22: J8.15, J9.15
GPIO23: J8.16, J9.16
GPIO24: J8.18, J9.18
GPIO25: J8.22, J9.22
GPIO26: J8.37, J9.37
GPIO27: J8.13, J9.13
I2C_SCL: J8.5, J9.5, U1.1 (SCL)
I2C_SDA: J8.3, J9.3, U1.4 (SDA//CE)
ID_SC: J8.28, J9.28
ID_SD: J8.27, J9.27
unnamed: B1.2 (+), C2.2, U1.19 (VBAT)
unnamed: C1.2, U1.5 (IFS), U1.18 (BBS)
unnamed: P1.A14, R5.1, S1.5
unnamed: P1.A15, R4.1, S1.4
unnamed: P1.A16, R3.1, S1.3
unnamed: P1.A17, R2.1, S1.2
unnamed: P1.A18, R1.1, S1.1
unnamed: R7.1, U2.1 (IN1)
unnamed: R8.1, U2.2 (IN2)
unnamed: R10.1, R11.2, U5.1 (ADJ)
unnamed: R12.1, U4.5 (TRIM)
PCM_CLK: J8.12, J9.12
RS485_A: J2.2, J5.2, P1.A9
RS485_B: J2.1, J5.1, P1.A8
SPI_CE0: J8.24, J9.24
SPI_CE1: J8.26, J9.26
SPI_MISO: J8.21, J9.21
SPI_MOSI: J8.19, J9.19
SPI_SCLK: J8.23, J9.23
UART_RX: J8.10, J9.10, U3.4 (RXD)
UART_TX: J8.8, J9.8, U3.1 (TXD)
ZERO_CROSS: J1.2, J4.2, P1.B8, R9.2, U2.5 (C)

Notes on the sheet:
Raspberry pi
Schéma électrique de la carte mère du mini monitron
Alfred Morel-Quintin et Maina Raiche
40 pins pour RASPBERRY PI
40 pins pour TEST
Alimentations PI
CAN
ZERO CROSS
RTC
PCIE
BORNIERS
Entrée 24VDC
Alimentations module

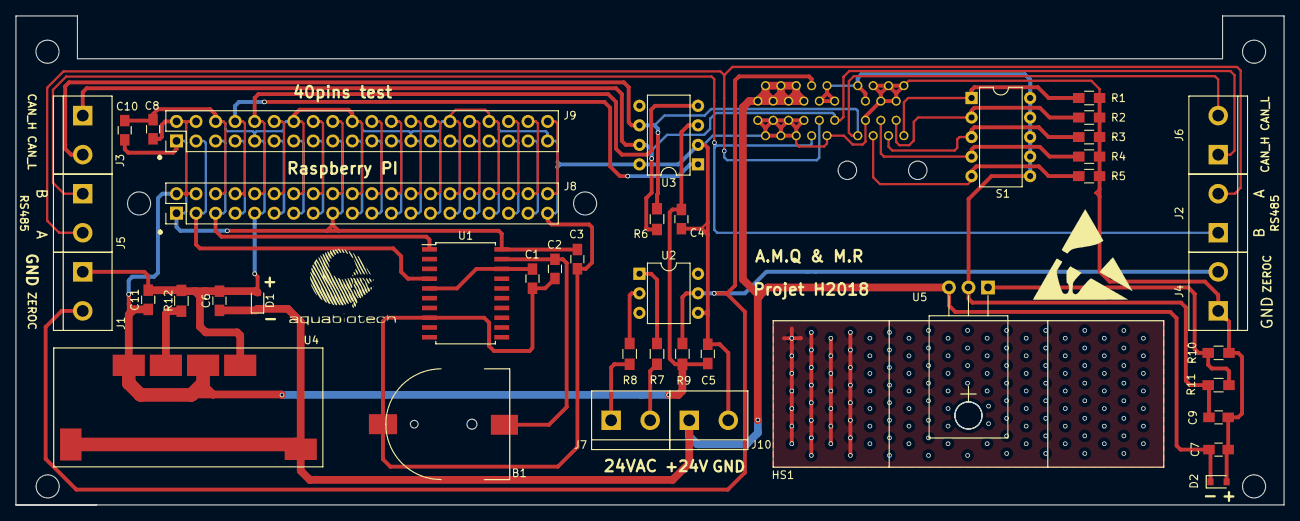
[picture p47: board MiniMonitron.kicad_pcb from above]

Board: 2 copper layers, 164.9 x 63.6 mm, 44 parts (0 on the bottom side), 51 nets.
