StokeDude18/m_monitron/BuildPi/moc_editline.cpp

/****************************************************************************
** Meta object code from reading C++ file 'editline.h'
**
** Created by: The Qt Meta Object Compiler version 67 (Qt 5.7.1)
**
** WARNING! All changes made in this file will be lost!
*****************************************************************************/

#include "editline.h"
#include <QtCore/qbytearray.h>
#include <QtCore/qmetatype.h>
#if !defined(Q_MOC_OUTPUT_REVISION)
#error "The header file 'editline.h' doesn't include <QObject>."
#elif Q_MOC_OUTPUT_REVISION != 67
#error "This file was generated using the moc from 5.7.1. It"
#error "cannot be used with the include files from this version of Qt."
#error "(The moc has changed too much.)"
#endif

QT_BEGIN_MOC_NAMESPACE
struct qt_meta_stringdata_EditLine_t {
    QByteArrayData data[4];
    char stringdata0[28];
};
#define QT_MOC_LITERAL(idx, ofs, len) \
    Q_STATIC_BYTE_ARRAY_DATA_HEADER_INITIALIZER_WITH_OFFSET(len, \
    qptrdiff(offsetof(qt_meta_stringdata_EditLine_t, stringdata0) + ofs \
        - idx * sizeof(QByteArrayData)) \
    )
static const qt_meta_stringdata_EditLine_t qt_meta_stringdata_EditLine = {
    {
QT_MOC_LITERAL(0, 0, 8), // "EditLine"
QT_MOC_LITERAL(1, 9, 8), // "focussed"
QT_MOC_LITERAL(2, 18, 0), // ""
QT_MOC_LITERAL(3, 19, 8) // "hasFocus"

    },
    "EditLine\0focussed\0\0hasFocus"
};
#undef QT_MOC_LITERAL

static const uint qt_meta_data_EditLine[] = {

 // content:
       7,       // revision
       0,       // classname
       0,    0, // classinfo
       1,   14, // methods
       0,    0, // properties
       0,    0, // enums/sets
       0,    0, // constructors
       0,       // flags
       1,       // signalCount

 // signals: name, argc, parameters, tag, flags
       1,    1,   19,    2, 0x06 /* Public */,

 // signals: parameters
    QMetaType::Void, QMetaType::Bool,    3,

       0        // eod
};

void EditLine::qt_static_metacall(QObject *_o, QMetaObject::Call _c, int _id, void **_a)
{
    if (_c == QMetaObject::InvokeMetaMethod) {
        EditLine *_t = static_cast<EditLine *>(_o);
        Q_UNUSED(_t)
        switch (_id) {
        case 0: _t->focussed((*reinterpret_cast< bool(*)>(_a[1]))); break;
        default: ;
        }
    } else if (_c == QMetaObject::IndexOfMethod) {
        int *result = reinterpret_cast<int *>(_a[0]);
        void **func = reinterpret_cast<void **>(_a[1]);
        {
            typedef void (EditLine::*_t)(bool );
            if (*reinterpret_cast<_t *>(func) == static_cast<_t>(&EditLine::focussed)) {
                *result = 0;
                return;
            }
        }
    }
}

const QMetaObject EditLine::staticMetaObject = {
    { &QLineEdit::staticMetaObject, qt_meta_stringdata_EditLine.data,
      qt_meta_data_EditLine,  qt_static_metacall, Q_NULLPTR, Q_NULLPTR}
};


const QMetaObject *EditLine::metaObject() const
{
    return QObject::d_ptr->metaObject ? QObject::d_ptr->dynamicMetaObject() : &staticMetaObject;
}

void *EditLine::qt_metacast(const char *_clname)
{
    if (!_clname) return Q_NULLPTR;
    if (!strcmp(_clname, qt_meta_stringdata_EditLine.stringdata0))
        return static_cast<void*>(const_cast< EditLine*>(this));
    return QLineEdit::qt_metacast(_clname);
}

int EditLine::qt_metacall(QMetaObject::Call _c, int _id, void **_a)
{
    _id = QLineEdit::qt_metacall(_c, _id, _a);
    if (_id < 0)
        return _id;
    if (_c == QMetaObject::InvokeMetaMethod) {
        if (_id < 1)
            qt_static_metacall(this, _c, _id, _a);
        _id -= 1;
    } else if (_c == QMetaObject::RegisterMethodArgumentMetaType) {
        if (_id < 1)
            *reinterpret_cast<int*>(_a[0]) = -1;
        _id -= 1;
    }
    return _id;
}

// SIGNAL 0
void EditLine::focussed(bool _t1)
{
    void *_a[] = { Q_NULLPTR, const_cast<void*>(reinterpret_cast<const void*>(&_t1)) };
    QMetaObject::activate(this, &staticMetaObject, 0, _a);
}
QT_END_MOC_NAMESPACE
