StokeDude18/m_monitron/BuildPi/moc_numpad.cpp

/****************************************************************************
** Meta object code from reading C++ file 'numpad.h'
**
** Created by: The Qt Meta Object Compiler version 67 (Qt 5.7.1)
**
** WARNING! All changes made in this file will be lost!
*****************************************************************************/

#include "numpad.h"
#include <QtCore/qbytearray.h>
#include <QtCore/qmetatype.h>
#if !defined(Q_MOC_OUTPUT_REVISION)
#error "The header file 'numpad.h' doesn't include <QObject>."
#elif Q_MOC_OUTPUT_REVISION != 67
#error "This file was generated using the moc from 5.7.1. It"
#error "cannot be used with the include files from this version of Qt."
#error "(The moc has changed too much.)"
#endif

QT_BEGIN_MOC_NAMESPACE
struct qt_meta_stringdata_Numpad_t {
    QByteArrayData data[5];
    char stringdata0[38];
};
#define QT_MOC_LITERAL(idx, ofs, len) \
    Q_STATIC_BYTE_ARRAY_DATA_HEADER_INITIALIZER_WITH_OFFSET(len, \
    qptrdiff(offsetof(qt_meta_stringdata_Numpad_t, stringdata0) + ofs \
        - idx * sizeof(QByteArrayData)) \
    )
static const qt_meta_stringdata_Numpad_t qt_meta_stringdata_Numpad = {
    {
QT_MOC_LITERAL(0, 0, 6), // "Numpad"
QT_MOC_LITERAL(1, 7, 12), // "digitClicked"
QT_MOC_LITERAL(2, 20, 0), // ""
QT_MOC_LITERAL(3, 21, 5), // "digit"
QT_MOC_LITERAL(4, 27, 10) // "onPadClick"

    },
    "Numpad\0digitClicked\0\0digit\0onPadClick"
};
#undef QT_MOC_LITERAL

static const uint qt_meta_data_Numpad[] = {

 // content:
       7,       // revision
       0,       // classname
       0,    0, // classinfo
       2,   14, // methods
       0,    0, // properties
       0,    0, // enums/sets
       0,    0, // constructors
       0,       // flags
       1,       // signalCount

 // signals: name, argc, parameters, tag, flags
       1,    1,   24,    2, 0x06 /* Public */,

 // slots: name, argc, parameters, tag, flags
       4,    1,   27,    2, 0x08 /* Private */,

 // signals: parameters
    QMetaType::Void, QMetaType::Int,    3,

 // slots: parameters
    QMetaType::Void, QMetaType::Int,    3,

       0        // eod
};

void Numpad::qt_static_metacall(QObject *_o, QMetaObject::Call _c, int _id, void **_a)
{
    if (_c == QMetaObject::InvokeMetaMethod) {
        Numpad *_t = static_cast<Numpad *>(_o);
        Q_UNUSED(_t)
        switch (_id) {
        case 0: _t->digitClicked((*reinterpret_cast< int(*)>(_a[1]))); break;
        case 1: _t->onPadClick((*reinterpret_cast< int(*)>(_a[1]))); break;
        default: ;
        }
    } else if (_c == QMetaObject::IndexOfMethod) {
        int *result = reinterpret_cast<int *>(_a[0]);
        void **func = reinterpret_cast<void **>(_a[1]);
        {
            typedef void (Numpad::*_t)(int );
            if (*reinterpret_cast<_t *>(func) == static_cast<_t>(&Numpad::digitClicked)) {
                *result = 0;
                return;
            }
        }
    }
}

const QMetaObject Numpad::staticMetaObject = {
    { &QDialog::staticMetaObject, qt_meta_stringdata_Numpad.data,
      qt_meta_data_Numpad,  qt_static_metacall, Q_NULLPTR, Q_NULLPTR}
};


const QMetaObject *Numpad::metaObject() const
{
    return QObject::d_ptr->metaObject ? QObject::d_ptr->dynamicMetaObject() : &staticMetaObject;
}

void *Numpad::qt_metacast(const char *_clname)
{
    if (!_clname) return Q_NULLPTR;
    if (!strcmp(_clname, qt_meta_stringdata_Numpad.stringdata0))
        return static_cast<void*>(const_cast< Numpad*>(this));
    return QDialog::qt_metacast(_clname);
}

int Numpad::qt_metacall(QMetaObject::Call _c, int _id, void **_a)
{
    _id = QDialog::qt_metacall(_c, _id, _a);
    if (_id < 0)
        return _id;
    if (_c == QMetaObject::InvokeMetaMethod) {
        if (_id < 2)
            qt_static_metacall(this, _c, _id, _a);
        _id -= 2;
    } else if (_c == QMetaObject::RegisterMethodArgumentMetaType) {
        if (_id < 2)
            *reinterpret_cast<int*>(_a[0]) = -1;
        _id -= 2;
    }
    return _id;
}

// SIGNAL 0
void Numpad::digitClicked(int _t1)
{
    void *_a[] = { Q_NULLPTR, const_cast<void*>(reinterpret_cast<const void*>(&_t1)) };
    QMetaObject::activate(this, &staticMetaObject, 0, _a);
}
QT_END_MOC_NAMESPACE
