StokeDude18/m_monitron/(commit log)

2018-01-20 Ajout de la classe module
2018-02-02 Fenetres d'edition pour les onglets Cycles et Lecture. Restriction d'entree dans les boites de texte
2018-02-05 Redimension des elements graphiques Ajout de toutes les fenetres d'edition de parametres
2018-02-12 Ajout du dossier du schema electrique et PCB
    [MiniMonitron.kicad_pcb, MiniMonitron.sch]
2018-02-12 Ajout dossier des fiches techniques
2018-02-12 Modification du schema électrique, + ajout de fiche technique
    [MiniMonitron.sch, _saved_MiniMonitron.sch]
2018-02-13 Ajout fiche technique + ajout alimentation sur schema electrique
    [MiniMonitron.sch, _saved_MiniMonitron.sch]
2018-02-19 Premier affichage interface a partir de donnees recues
2018-02-19 Fonctions de lecture
2018-02-20 ajout fiches technique + finalisation schema électrique + commencement PCB
    [MiniMonitron.sch]
2018-02-20 Ajout de communications standardisées entre la form et le main
2018-02-23 Placement des pièces sur le PCB + commencement du routage
    [MiniMonitron.kicad_pcb, MiniMonitron.sch]
2018-03-12 Tous les paramètres sont affichés dans l'interface
2018-03-13 PCB terminé et envoyé, fichiers gerber crées + création du dossier Documentations avec le document du manuel technique
    [MiniMonitron-B.Cu.gbr, MiniMonitron-B.Mask.gbr, MiniMonitron-B.SilkS.gbr, MiniMonitron-Cmts.User.gbr, MiniMonitron-Dwgs.User.gbr, MiniMonitron-Edge.Cuts.gbr, MiniMonitron-F.Cu.gbr, MiniMonitron-F.Mask.gbr]
2018-03-13 Trames d'envoi des parmètres construite
2018-03-20 Version fonctionnelle comprenant l'édition de paramètres et l'acquisition de ceux-ci
2018-03-27 Code commenté de la première version fonctionnelle
2018-04-10 Correction du PCB + nouveau fichier Gerber
    [MiniMonitron-B.Cu.gbr, MiniMonitron-B.Mask.gbr, MiniMonitron-B.SilkS.gbr, MiniMonitron-Cmts.User.gbr, MiniMonitron-Dwgs.User.gbr, MiniMonitron-Edge.Cuts.gbr, MiniMonitron-F.Cu.gbr, MiniMonitron-F.Mask.gbr]
2018-04-17 Organisation des chiffres du numpad révisée
2018-04-26 Ménage des fichiers de build spécifiques aux systèmes utilisés pour les tests
2018-04-30 Retrait des classes graphiques des fenêtres d'édition
2018-04-30 PCB final + avancement du manuel technique
    [MiniMonitron-B.Cu.gbr, MiniMonitron-B.Mask.gbr, MiniMonitron-B.SilkS.gbr, MiniMonitron-Cmts.User.gbr, MiniMonitron-Dwgs.User.gbr, MiniMonitron-Edge.Cuts.gbr, MiniMonitron-F.Cu.gbr, MiniMonitron-F.Mask.gbr]
2018-04-30 Ajustements du code sans les classes graphiques
2018-04-30 Ajout de marqueurs d'édition et Séquence calibration
2018-05-08 Ajout de protection quand aucun module détecté et de détails sur le module dans le combo box de sélection du module actif
2018-05-11 Ajustements de bugs dans le choix du mode d'opération
    [editline.h, m_monitron_0_0.cpp, m_monitron_0_0.h, main.cpp, moc_m_monitron_0_0.cpp, ui_m_monitron_0_0.h]
2018-05-14 Ajout de commentaires dans les classes m_monitron_0_0, Edtiline et Numpad
2018-05-14 Complément des commentaires commencés dans le dernier commit
2018-05-15 Avancement des corrections du manuel technique + ajout photos et screenshots
    [MiniMonitron.kicad_pcb]
2018-05-15 Ajout de détails dans la procédure d'installation et reformulation de quelques passages dans le manuel technique
2018-05-15 Reformulation d'une phrase dans la description du projet
2018-05-18 Ajout de la valeur en mV actuelle sur le clavier virtuel quand le mode calibration est actif
2018-05-18 retrait de la barre de titre du numpad pour libérer de l'espace
2018-05-21 Ajout des en-tête de fichiers sur tous les fichier .cpp et .h du projet
2018-05-22 Correction du bug ttyUSB0 vs serial0 dans le build du PI
    [DBAccess.cpp, DBAccess.h, editline.cpp, m_monitron_0_0.cpp, m_monitron_0_0.h, main.cpp, module.cpp, module.h]
2018-05-22 Ajout des unités des valeurs de lectureet réorganisation de l'onglet Control_OP
